AllAboutCircuits/C-BISCUIT/README.md

# C-BISCUIT
C-BISCUIT is a modular DIY robotic vehicle design based on the Freescale i.MX6 Wandboard and the Robotic Operating System (ROS).
