AllAboutCircuits/C-BISCUIT/core/power/README.md

# Power

## TODO

* Select R, C if special (power, ESR, whatever)
* Mega-Fit footprints
* Mounting hole footprints
* Fuse
    * Select holder
    * Make footprint
* Inductor footprint
* IC footprints?
* PCB layout
