AllAboutCircuits/C-BISCUIT/doc/research/README.md

# Research

This is a list of academic white papers and research articles used in the development of C-BISCUIT.

## Computer Vision

### LSD-SLAM: Large-Scale Direct Monocular SLAM
* [White Paper (PDF)](./lsd-slam.pdf)
* [Website](http://vision.in.tum.de/research/vslam/lsdslam)
* [Github](https://github.com/tum-vision/lsd_slam)

### SVO: Fast Semi-Direct Monocular Visual Odometry
* [White Paper (PDF)](./svo.pdf)
* [Demo Video](https://www.youtube.com/watch?v=2YnIMfw6bJY)
* [Github](https://github.com/uzh-rpg/rpg_svo)

### Digital Video Stabilization and Rolling Shutter Correction using Gyroscopes
* [White Paper](./rolling-shutter-gyro.pdf)
* [Website](https://graphics.stanford.edu/papers/stabilization/)
* [Github](https://github.com/alexgo1/Video-Stabilization)
