AllAboutCircuits/C-BISCUIT/core/wandboard/datasheets/README.md

# Datasheets

This is an incomplete list of parts on the Wandboard. They are included because we interact with them directly in some way and having the datasheet on hand would help with that process. Complete parts lists are in the schematics in [user-docs](../user-docs/).

* **[AME8816](./ame8816.pdf)** - 1.5A CMOS LDO. Provides 3.3V through header J2
