AllAboutCircuits/C-BISCUIT/core/wandboard/user-docs/README.md

# Wandboard Documentation and Materials

Local cache of the docs and files on the [Wandboard Downloads](http://www.wandboard.org/downloads) page.

* [Wandboard Quick Start Guide ](./wb-quick-start-guide.pdf)
* [Wandboard QUAD REV B1 Userguide + Schematics ](./wbq-rev-b1-guide-schem.pdf)
* [Wandboard CPU MOdule REV C1 Schematics ](./wb-cpu-module-rev-c1-schem.pdf)
* [Wandboard Baseboard REV C1 Schematics ](./wb-baseboard-rev-c1-schem.pdf)
* [Wandboard Enclosure Assembling Guide](./wb-enclosure-guide.pdf)
* [Wandboard 2D files ](./wb-2d-files.zip)
* [Wandboard Quad + Heatsink 3D files ](./wbq-3d-files.zip)
* [Enclosure 3D files](./wb-enclosure-3d-files.zip)
