AllAboutCircuits/C-BISCUIT/doc/articles/assets/2016-05-10 19.06.01.jpg

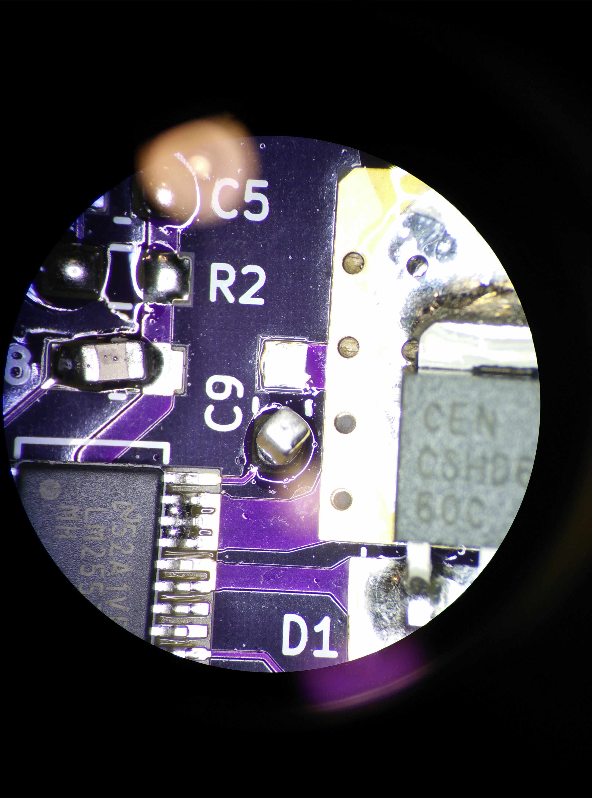
doc/articles/assets/2016-05-10 19.06.01.jpg
