AllAboutCircuits/C-BISCUIT/doc/articles/assets/2016-05-18 18.38.54.jpg

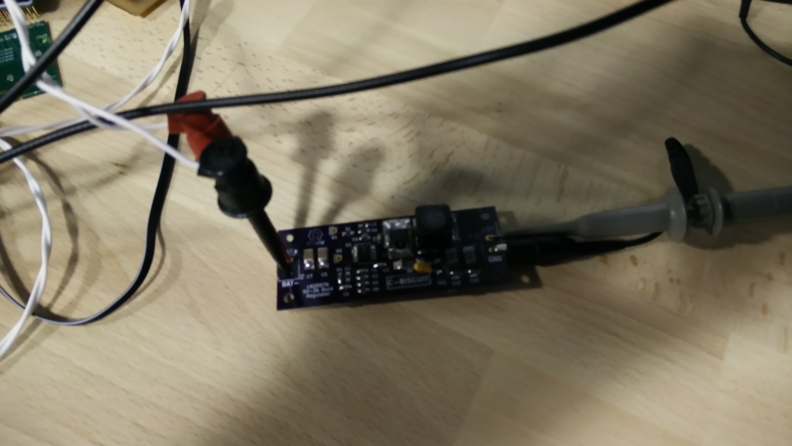
doc/articles/assets/2016-05-18 18.38.54.jpg
