AllAboutCircuits/C-BISCUIT/doc/articles/assets/crowbar_2016-03-14 15.54.27.jpg

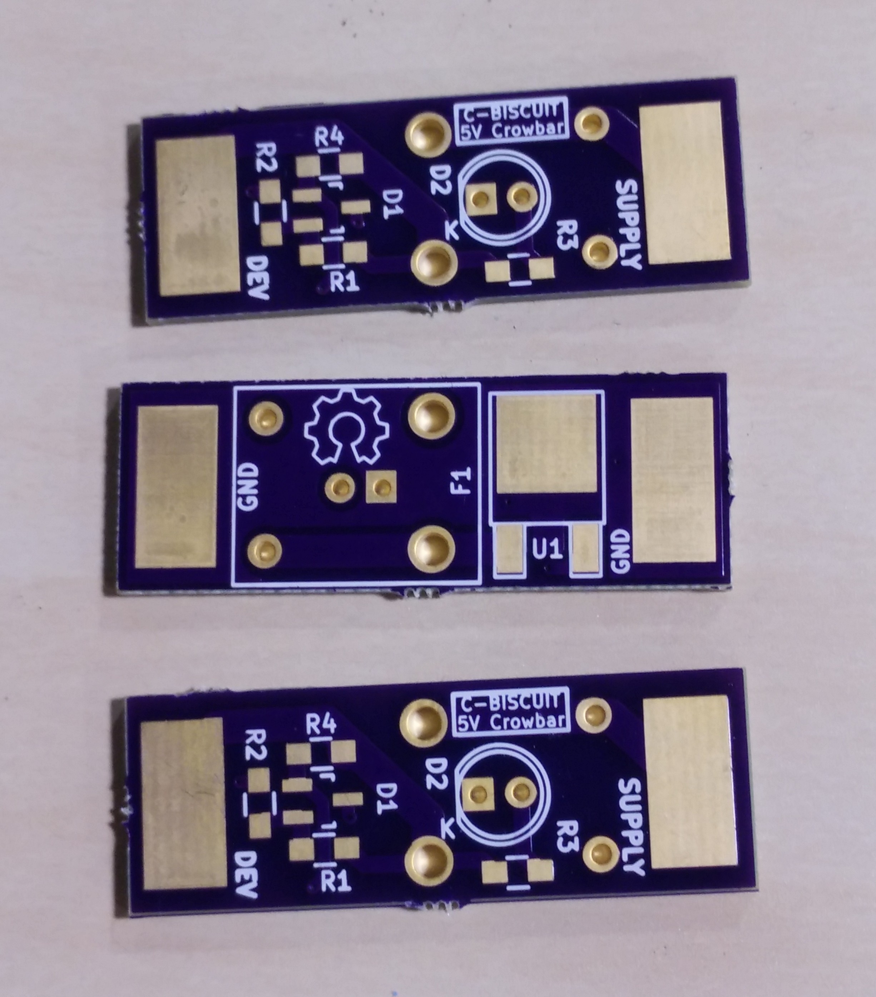
doc/articles/assets/crowbar_2016-03-14 15.54.27.jpg
