AllAboutCircuits/C-BISCUIT/doc/articles/assets/electricity-res.jpg

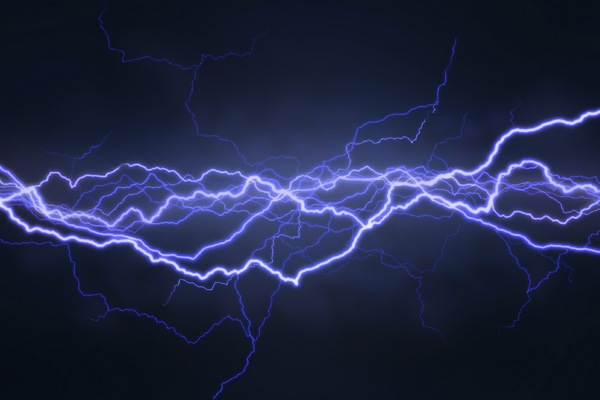
doc/articles/assets/electricity-res.jpg
