AllAboutCircuits/C-BISCUIT/doc/articles/assets/gordon-freeman-crowbar.jpg

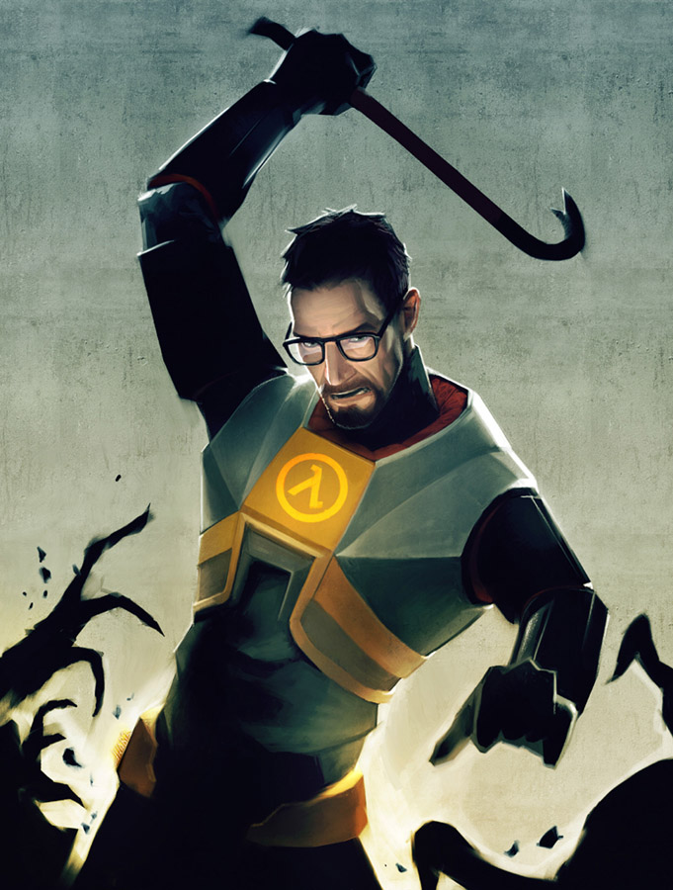
doc/articles/assets/gordon-freeman-crowbar.jpg
