AllAboutCircuits/C-BISCUIT/doc/articles/assets/reflow-profile.jpg

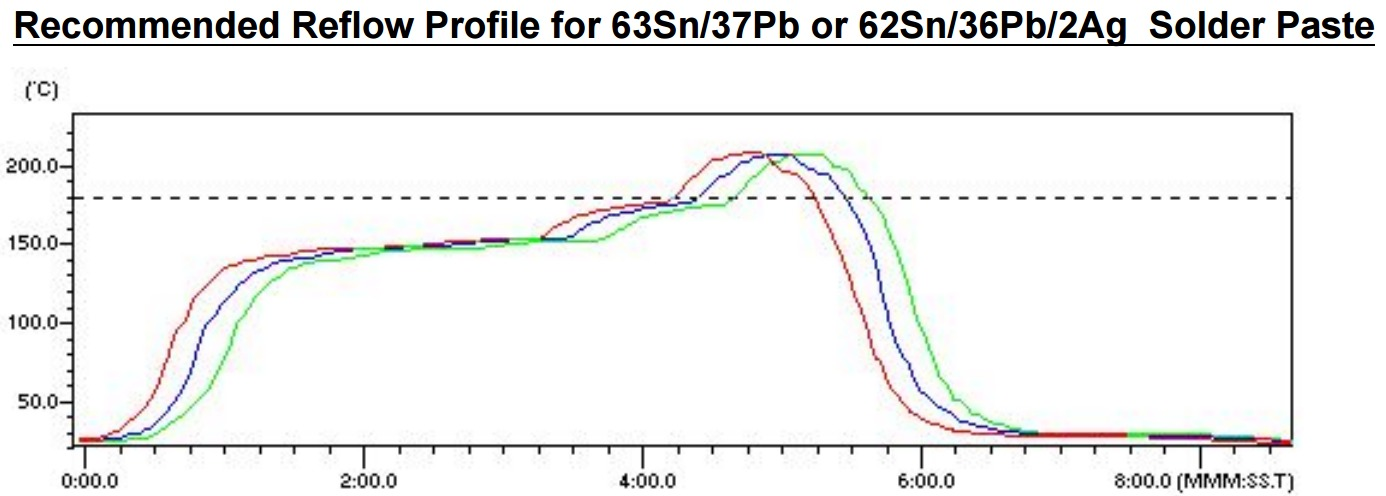
doc/articles/assets/reflow-profile.jpg
