AllAboutCircuits/C-BISCUIT/doc/articles/assets/reg_2016-05-10 17.44.28.jpg

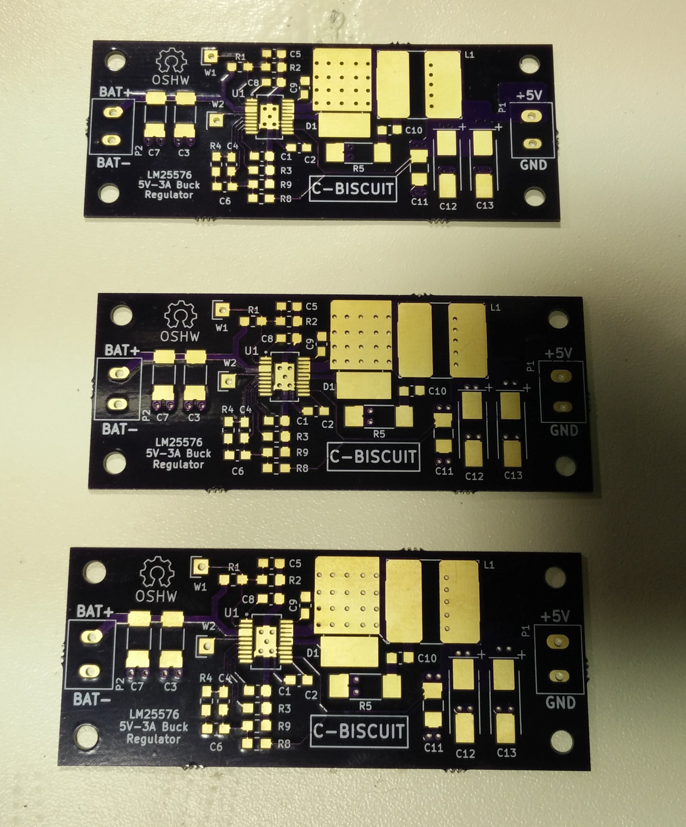
doc/articles/assets/reg_2016-05-10 17.44.28.jpg
