AllAboutCircuits/C-BISCUIT/doc/articles/assets/triac_quad_iii.jpg

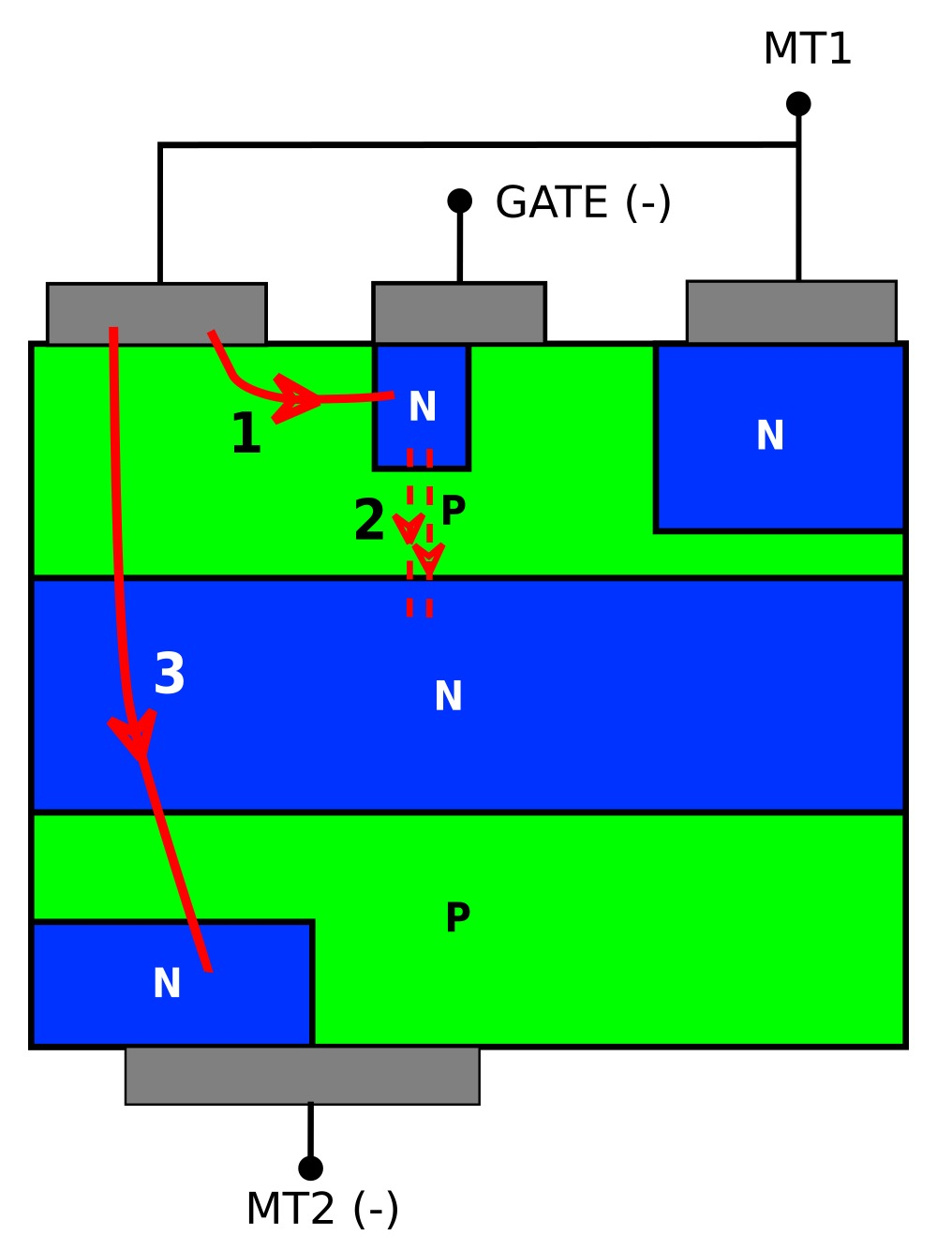
doc/articles/assets/triac_quad_iii.jpg
