AllAboutCircuits/C-BISCUIT/core/wandboard/user-docs/wb-enclosure-guide.pdf

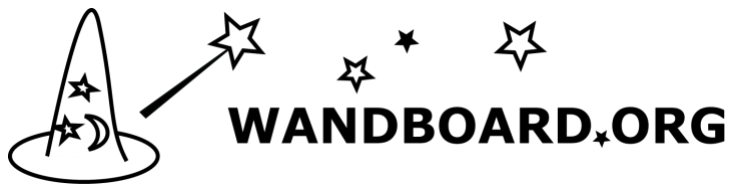
[picture p42: figure]

# Assembly Guide Enclosure

If you do not need to attach an antenna, just follow steps 1,4 and 6.

Step 1 - Place the top-case on a soft surface

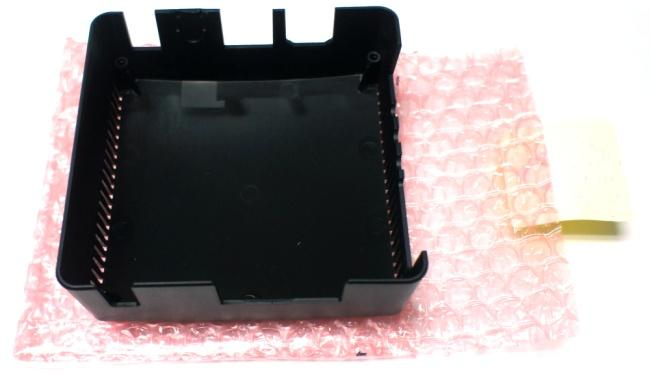
[picture p43: figure]

Step 2 (optional)- If you have a Wandboard with Wi-Fi capabilities (Wandboard DUAL). You will need to open the antenna opening

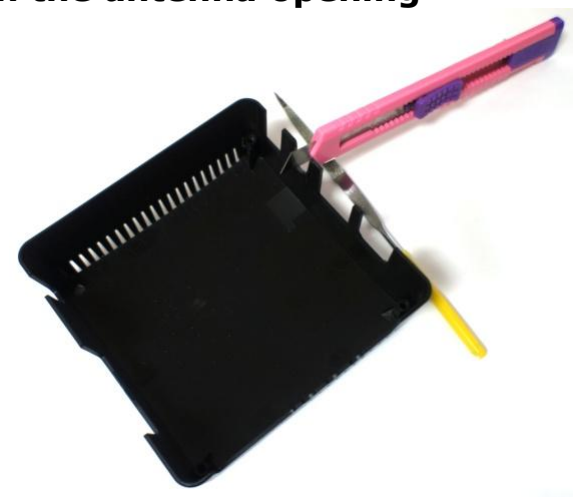
[picture p44: figure]
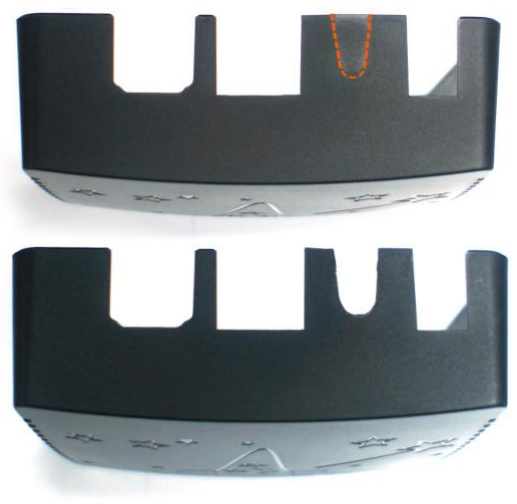
[picture p45: figure]

Step 3 (optional)- Connect the Wi-Fi cable: plug the cable in the μFL IPEX connector and lead it through the open hole to the other side

After

Before

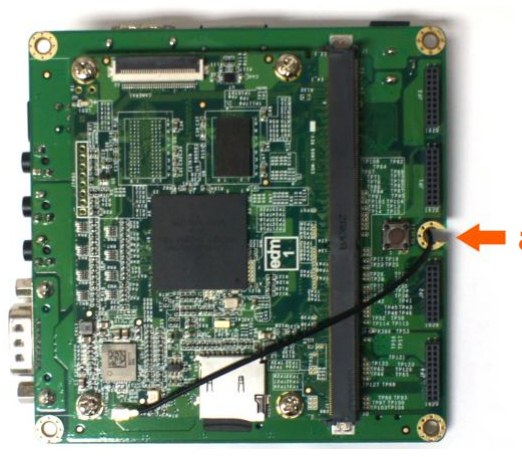
[picture p46: figure]

hole for
antenna
cable

Step 4 - Insert your Wandboard (remember to insert SD-card with OS in the module first)

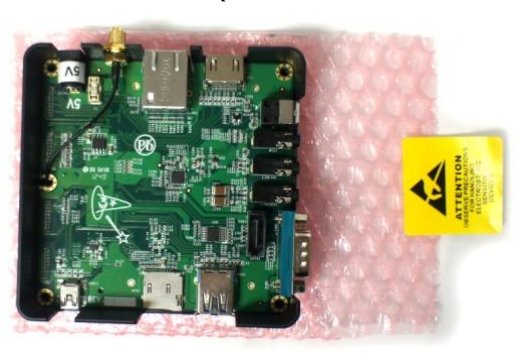
[picture p47: figure]

Step 5 (optional) - Make sure the bolt has the correct orientation, and then fasten it (the rings should be on the outside of the case)

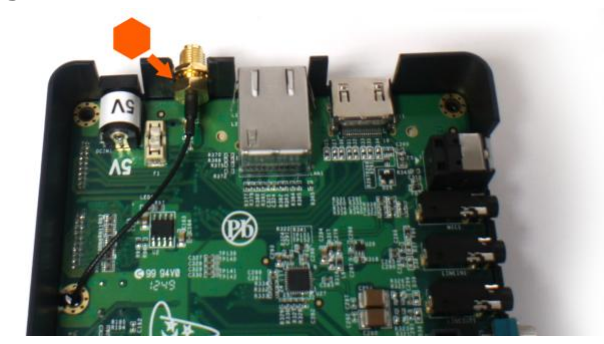
[picture p48: figure]

Step 6 - Insert and fasten the bottom-enclosure with the screws and attach the rubber feet.

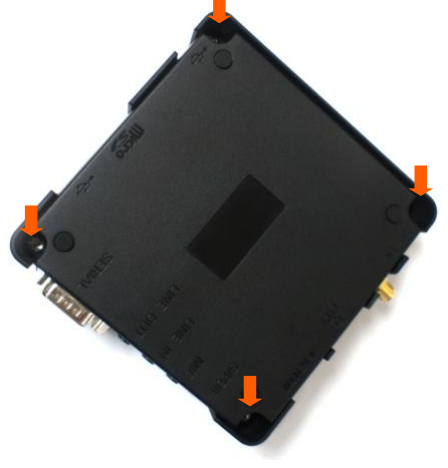
[picture p49: figure]
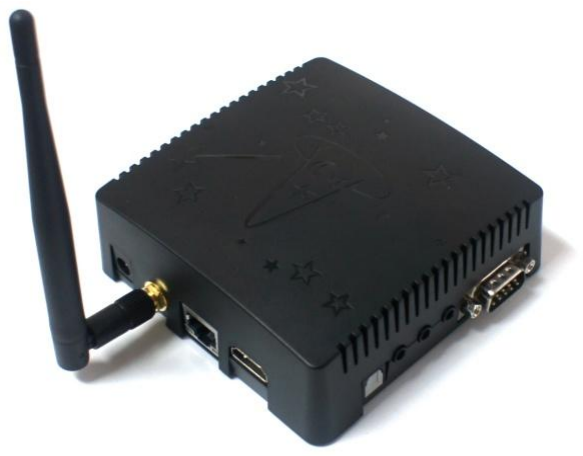
[picture p50: figure]

Step 7 (optional) - Attach the antenna.
