AllAboutCircuits/C-BISCUIT/core/wandboard/user-docs/wb-baseboard-rev-c1-schem.pdf

# PCB SN:100300490411 L=4, 95 x 95 mm

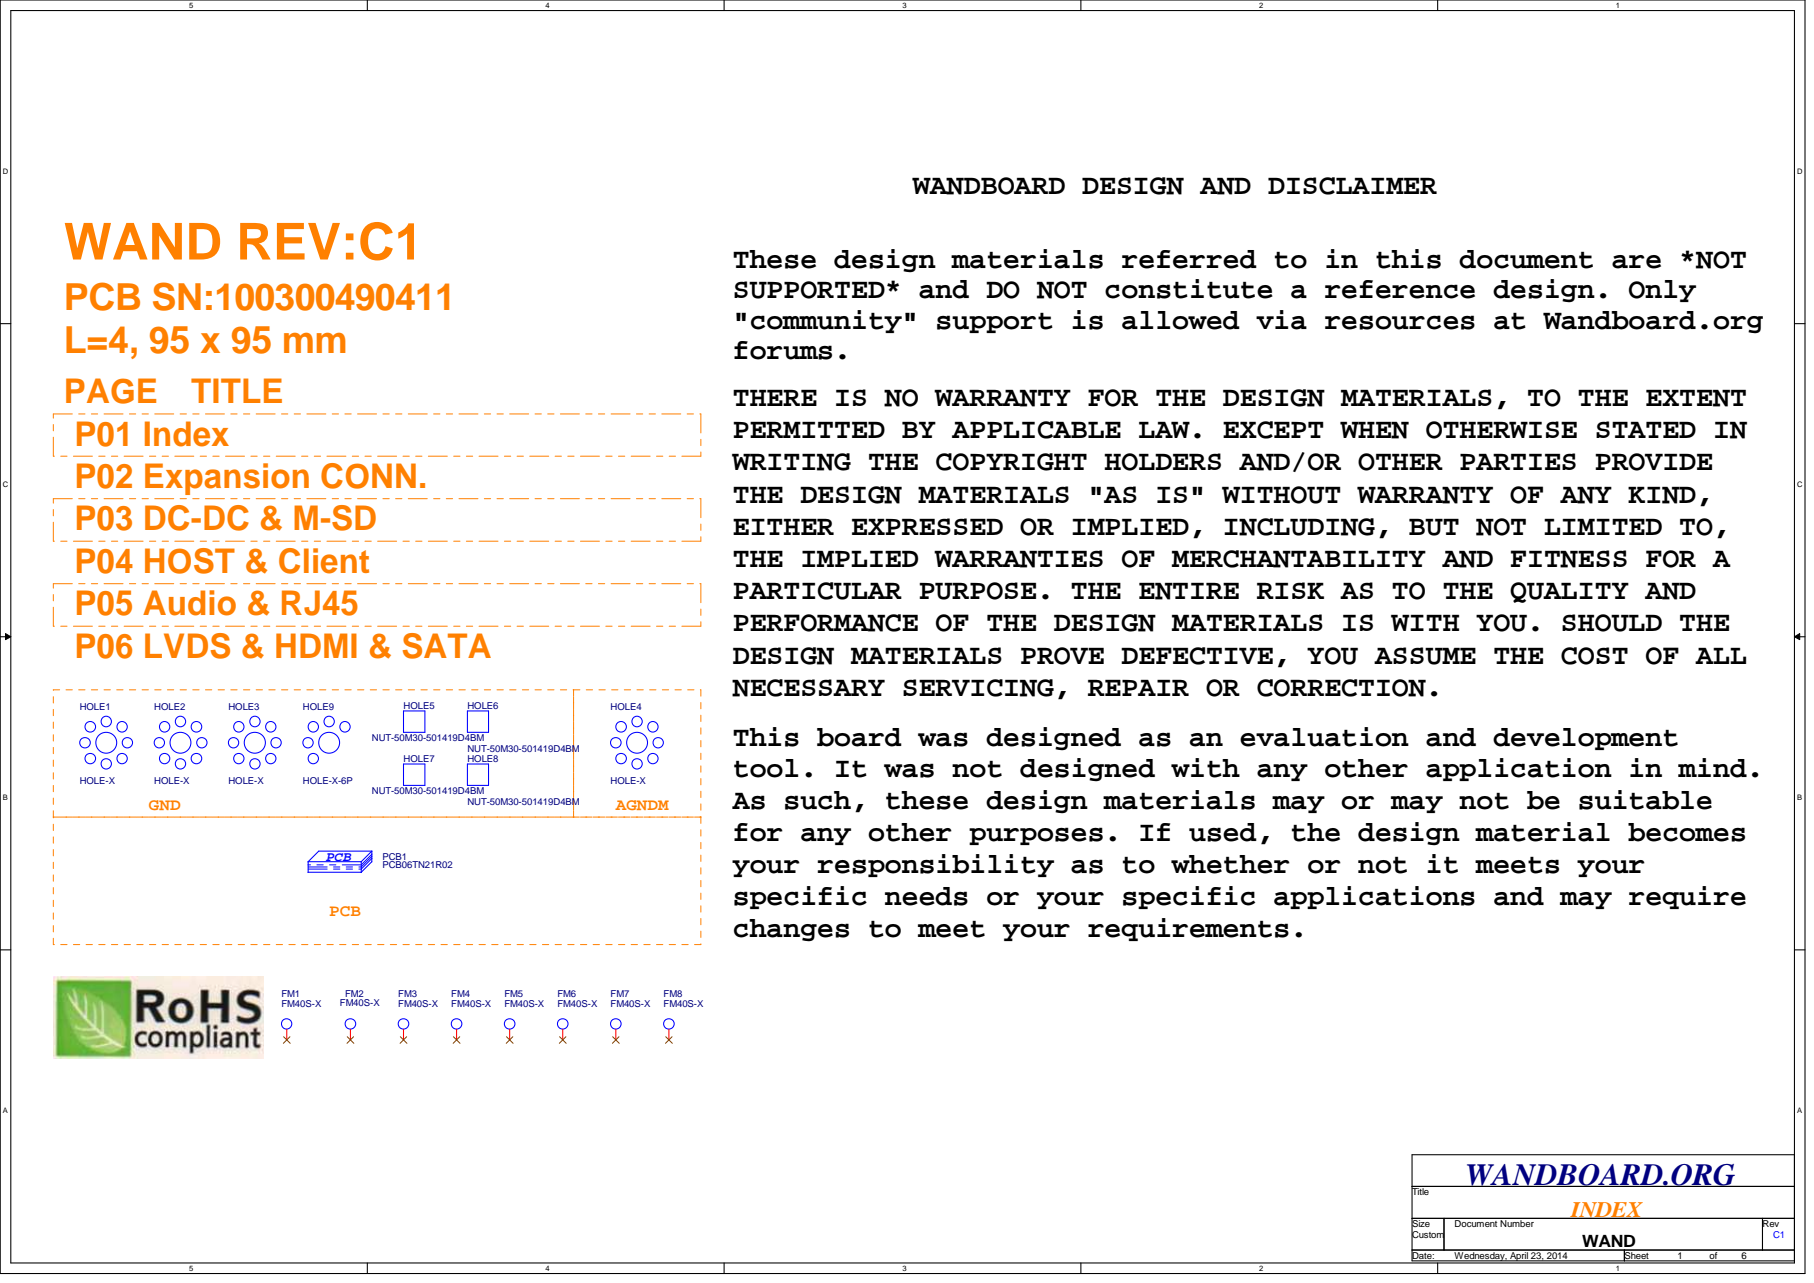
[picture p83: page 1]
WAND REV:C1; GND; AGNDM; PCB; INDEX; WANDBOARD.ORG; Title; HOLE9; HOLE-X-6P; HOLE4; HOLE-X; HOLE3; HOLE6; NUT-50M30-501419D4BM; HOLE2; HOLE5; HOLE7; HOLE8; PCB06TN21R02; PCB1; HOLE1

WANDBOARD DESIGN AND DISCLAIMER

These design materials referred to in this document are *NOT
SUPPORTED* and DO NOT constitute a reference design. Only
"community" support is allowed via resources at Wandboard.org
forums.
THERE IS NO WARRANTY FOR THE DESIGN MATERIALS, TO THE EXTENT
PERMITTED BY APPLICABLE LAW. EXCEPT WHEN OTHERWISE STATED IN
WRITING THE COPYRIGHT HOLDERS AND/OR OTHER PARTIES PROVIDE
THE DESIGN MATERIALS "AS IS" WITHOUT WARRANTY OF ANY KIND,
EITHER EXPRESSED OR IMPLIED, INCLUDING, BUT NOT LIMITED TO,
THE IMPLIED WARRANTIES OF MERCHANTABILITY AND FITNESS FOR A
PARTICULAR PURPOSE. THE ENTIRE RISK AS TO THE QUALITY AND
PERFORMANCE OF THE DESIGN MATERIALS IS WITH YOU. SHOULD THE
DESIGN MATERIALS PROVE DEFECTIVE, YOU ASSUME THE COST OF ALL
NECESSARY SERVICING, REPAIR OR CORRECTION.
This board was designed as an evaluation and development
tool. It was not designed with any other application in mind.
As such, these design materials may or may not be suitable
for any other purposes. If used, the design material becomes
your responsibility as to whether or not it meets your
specific needs or your specific applications and may require
changes to meet your requirements.

PAGE TITLE
P01 Index
P02 Expansion CONN.
P04 HOST & Client
P05 Audio & RJ45
P06 LVDS & HDMI & SATA

Size Custom | Document Number WAND | Rev C1

Date: Wednesday, April 23, 2014 | Sheet 1 of 6

# Board to Board

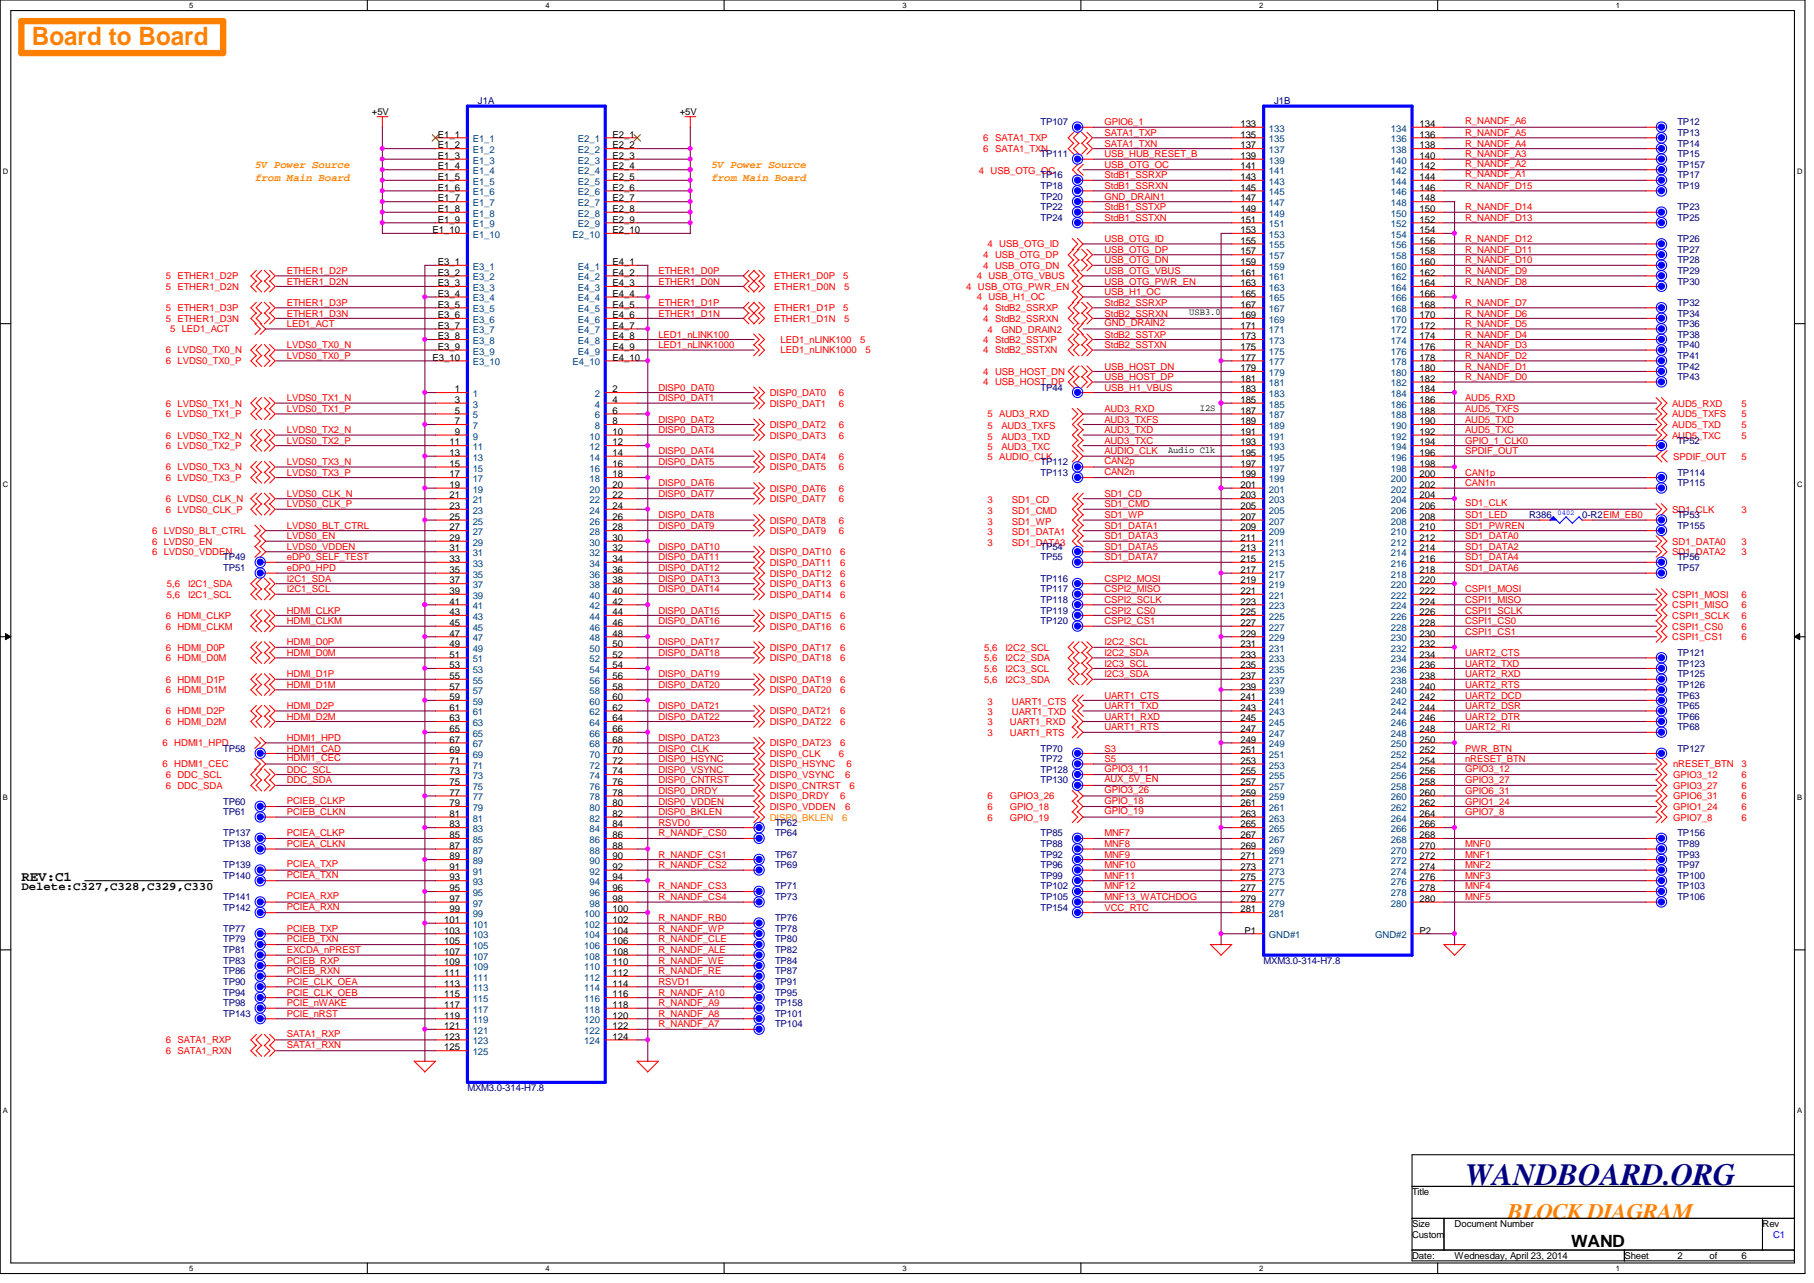
[picture p84: page 2]

# DC-DC

# DC JACK

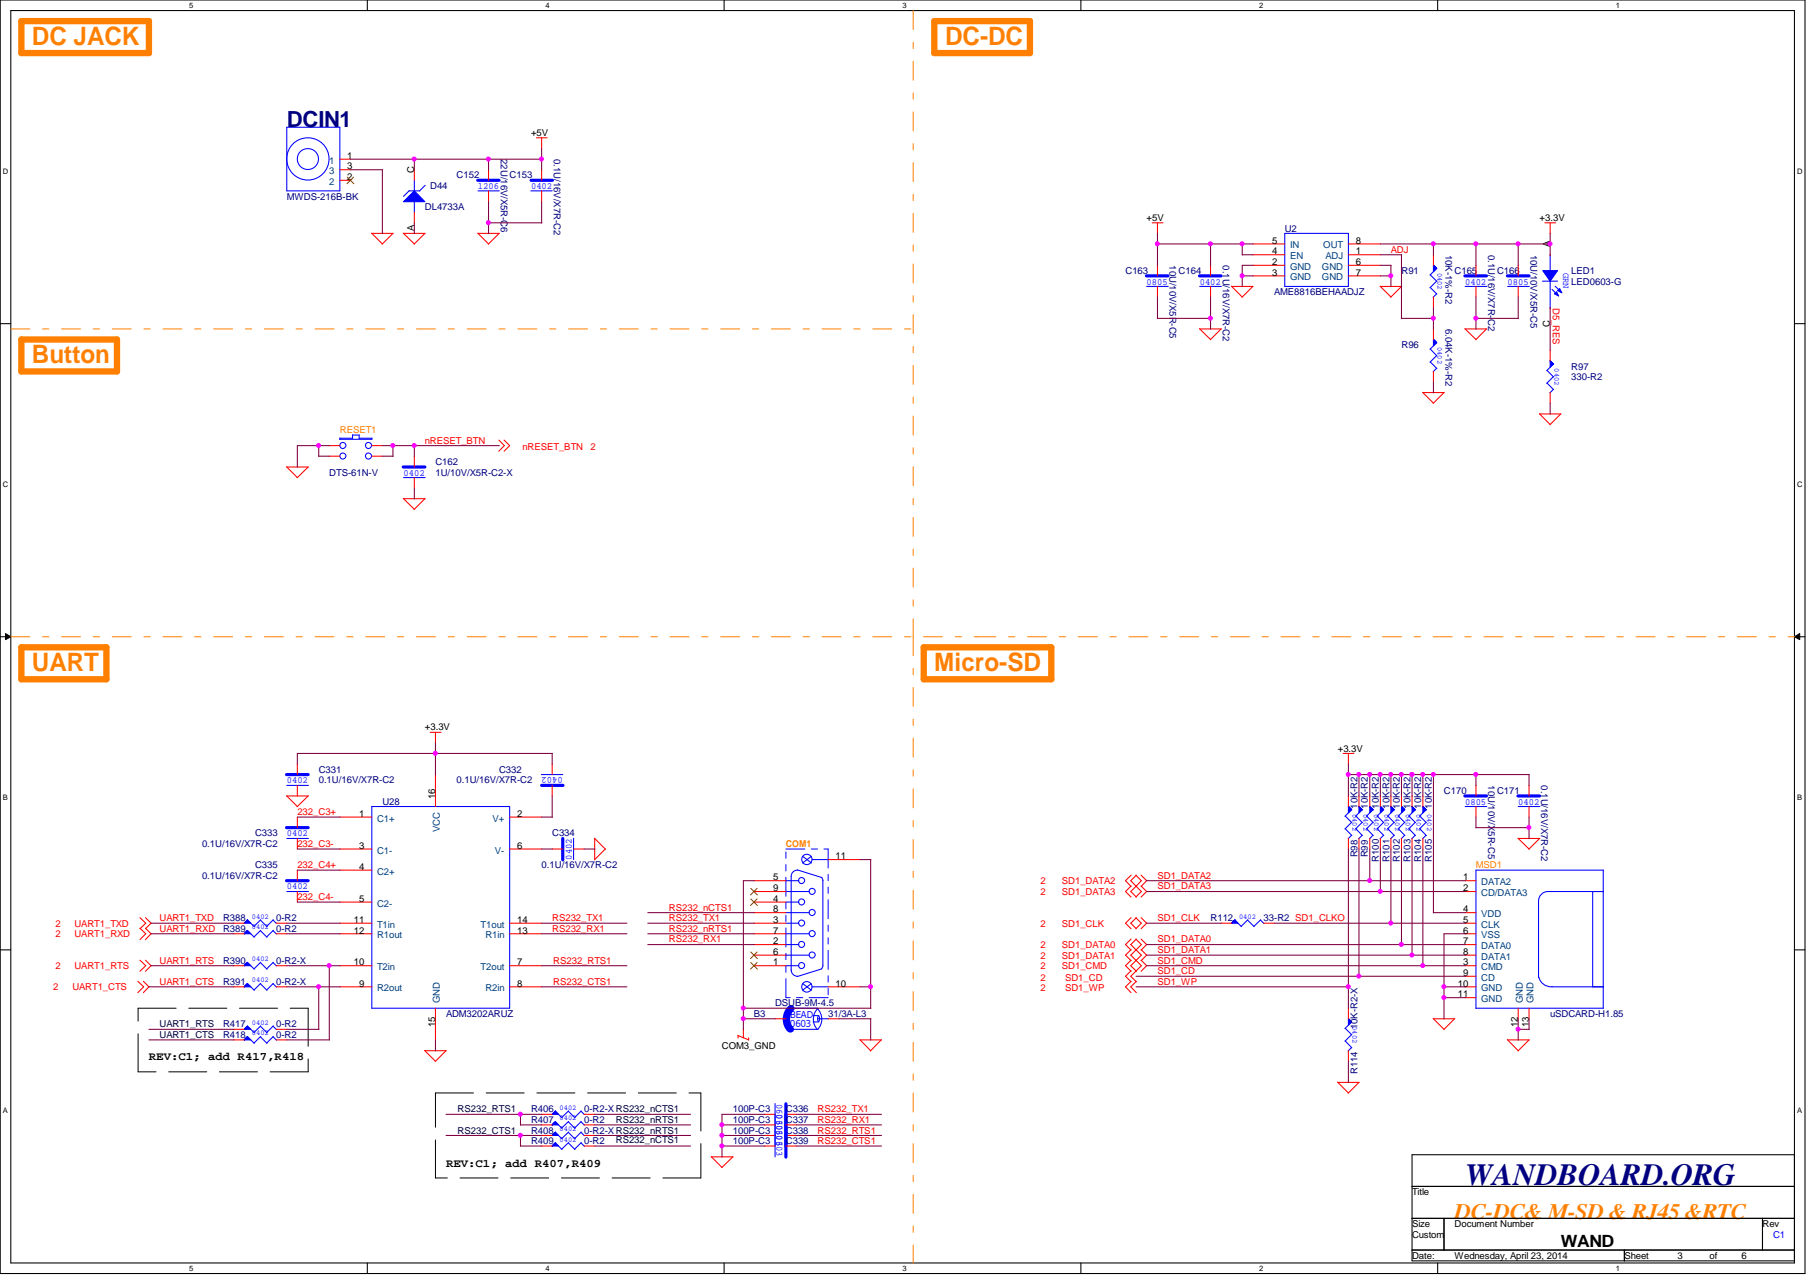
[picture p85: page 3]

WANDBOARD.ORG
DC-DC& M-SD & RJ45 &RTC

# HOST USB

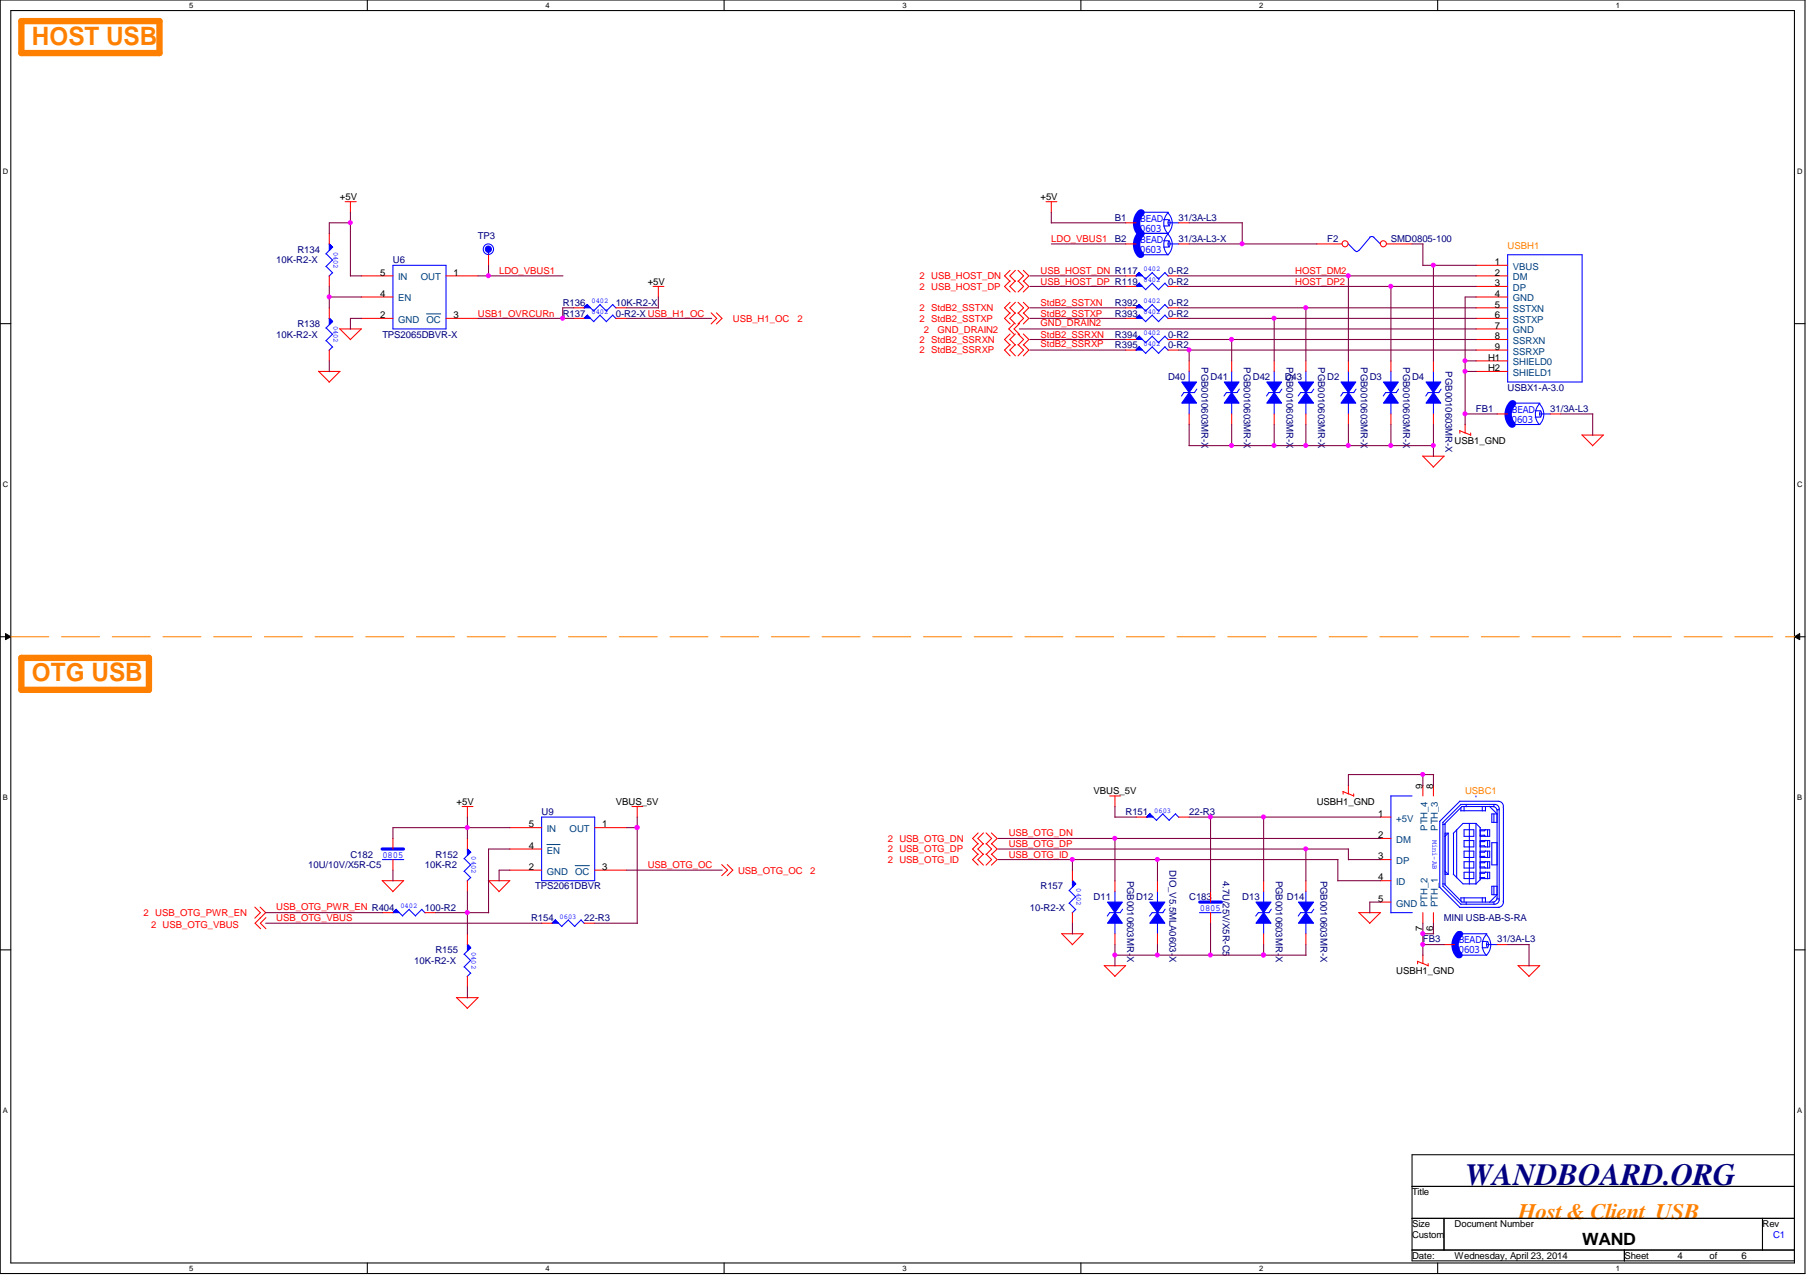
[picture p86: page 4]

MINI USB-AB-S-RA

# AUDIO

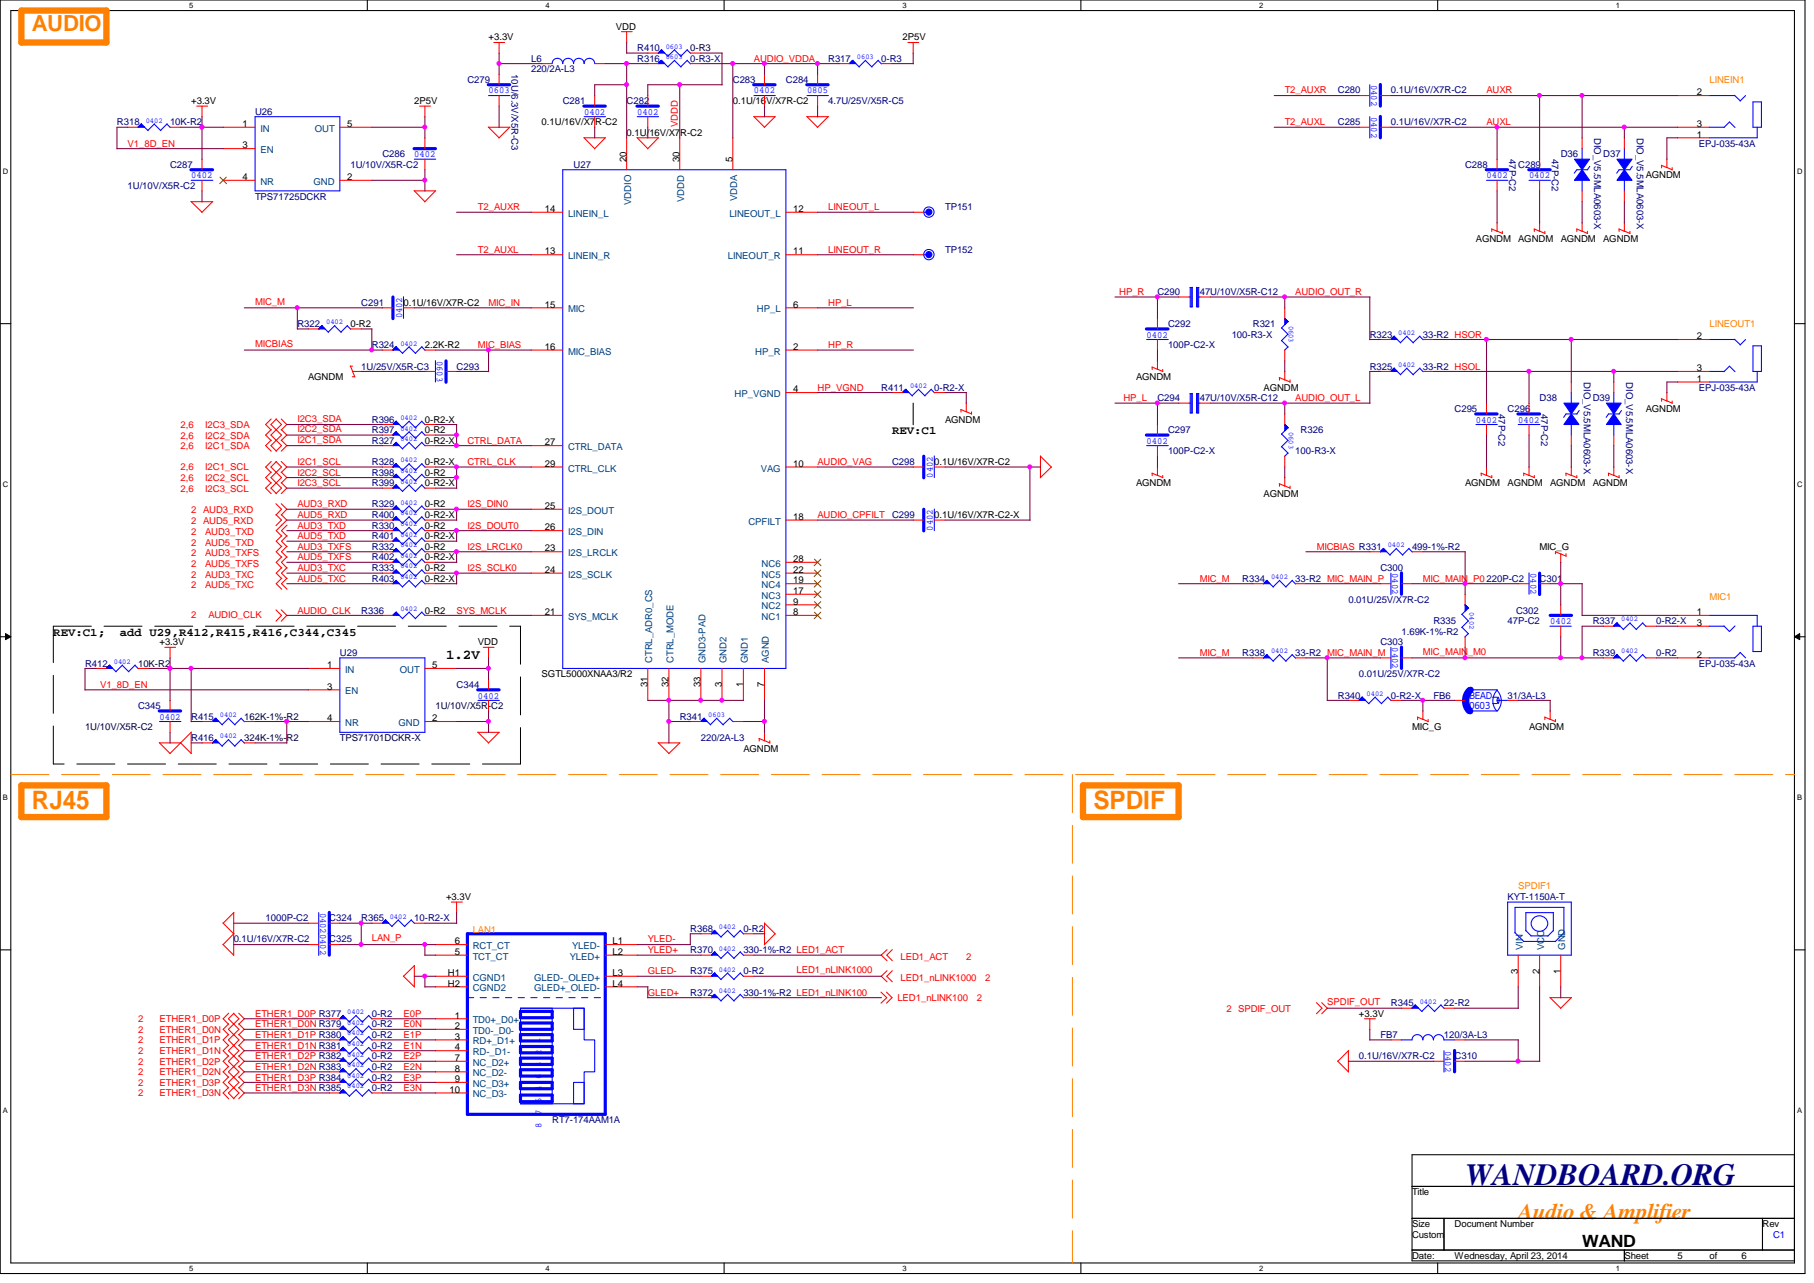
[picture p87: page 5]

AGNDM AGNDM

# TTL

# LVDS

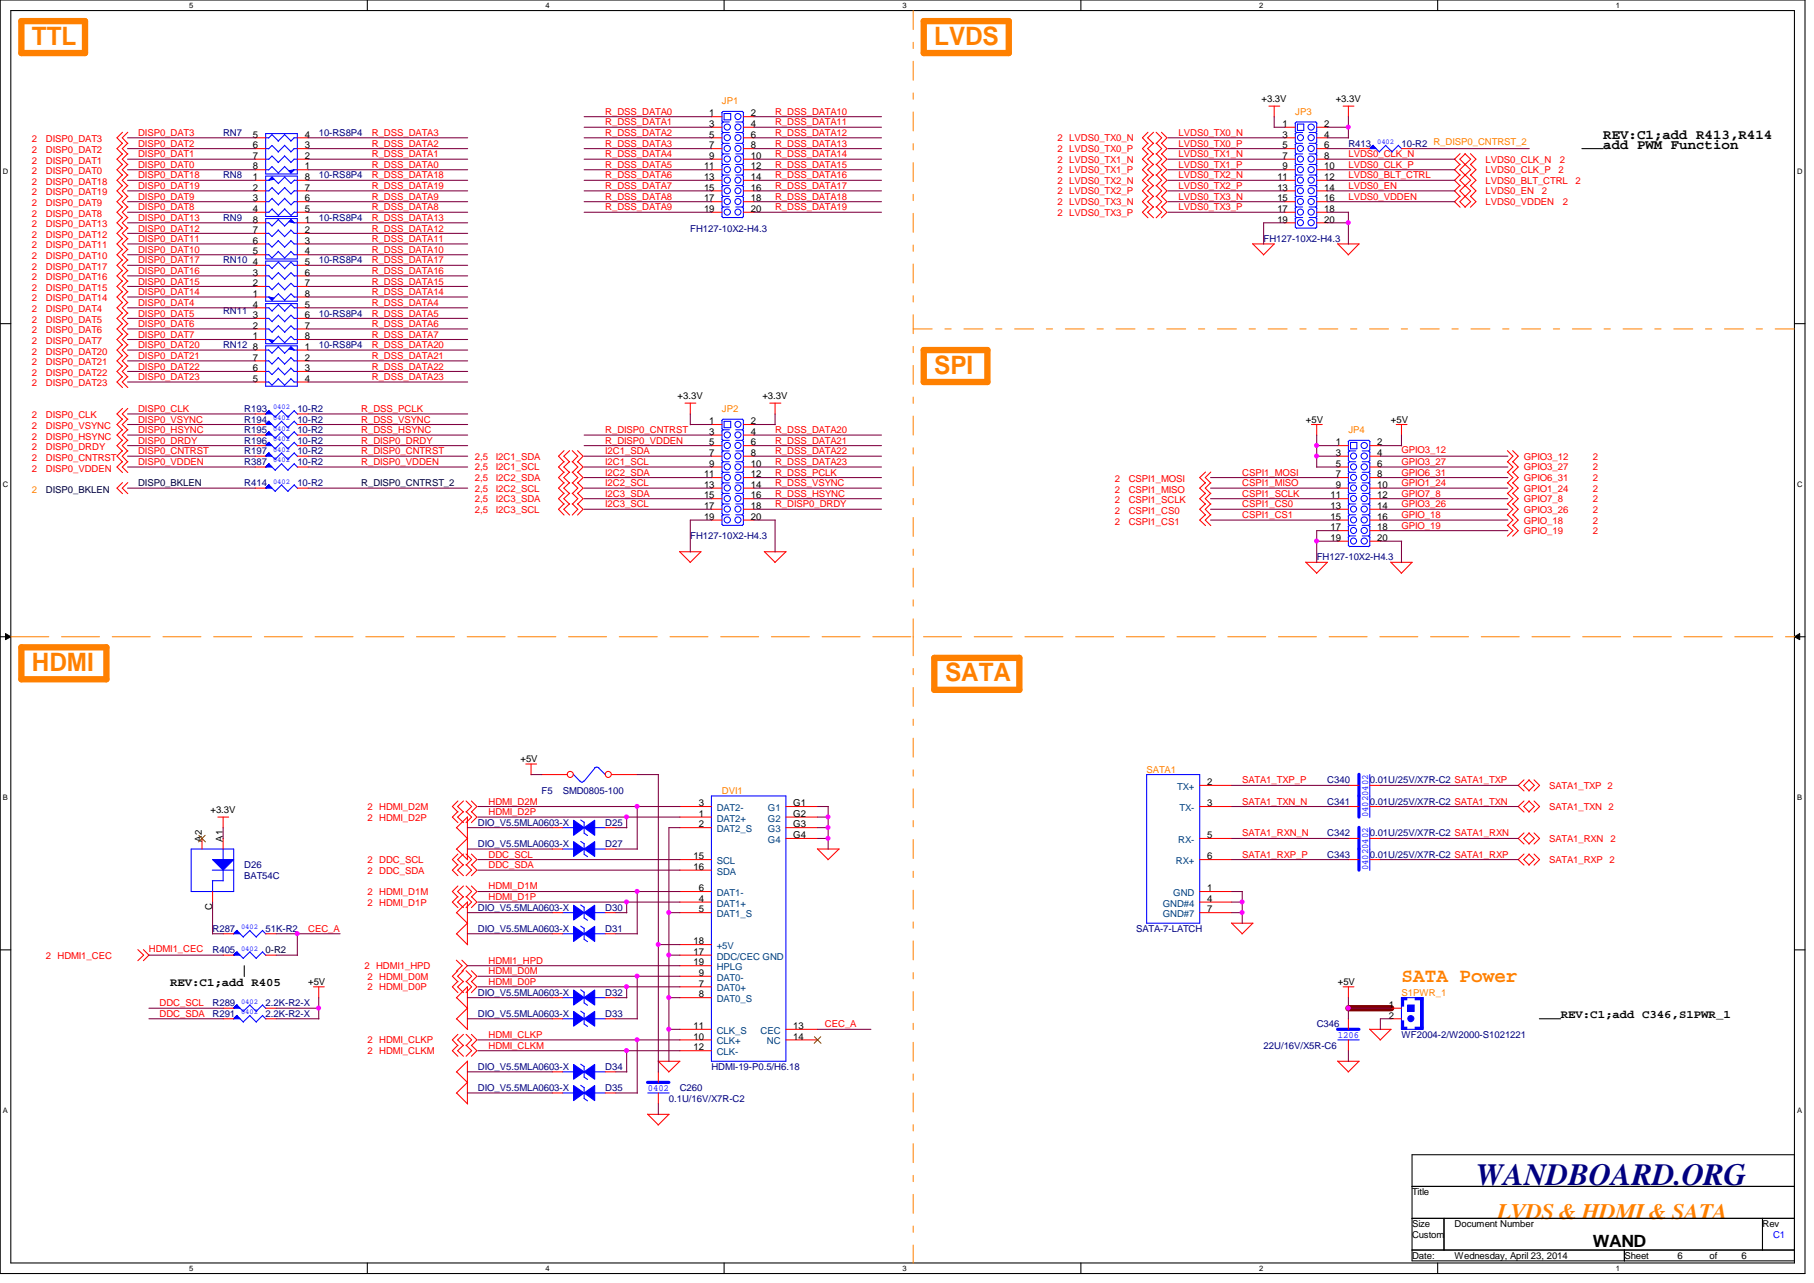
[picture p88: page 6]
