AllAboutCircuits/C-BISCUIT/core/wandboard/user-docs/wb-cpu-module-rev-c1-schem.pdf

# L=8, 82 x 60mm

# PCB SN:101200480811

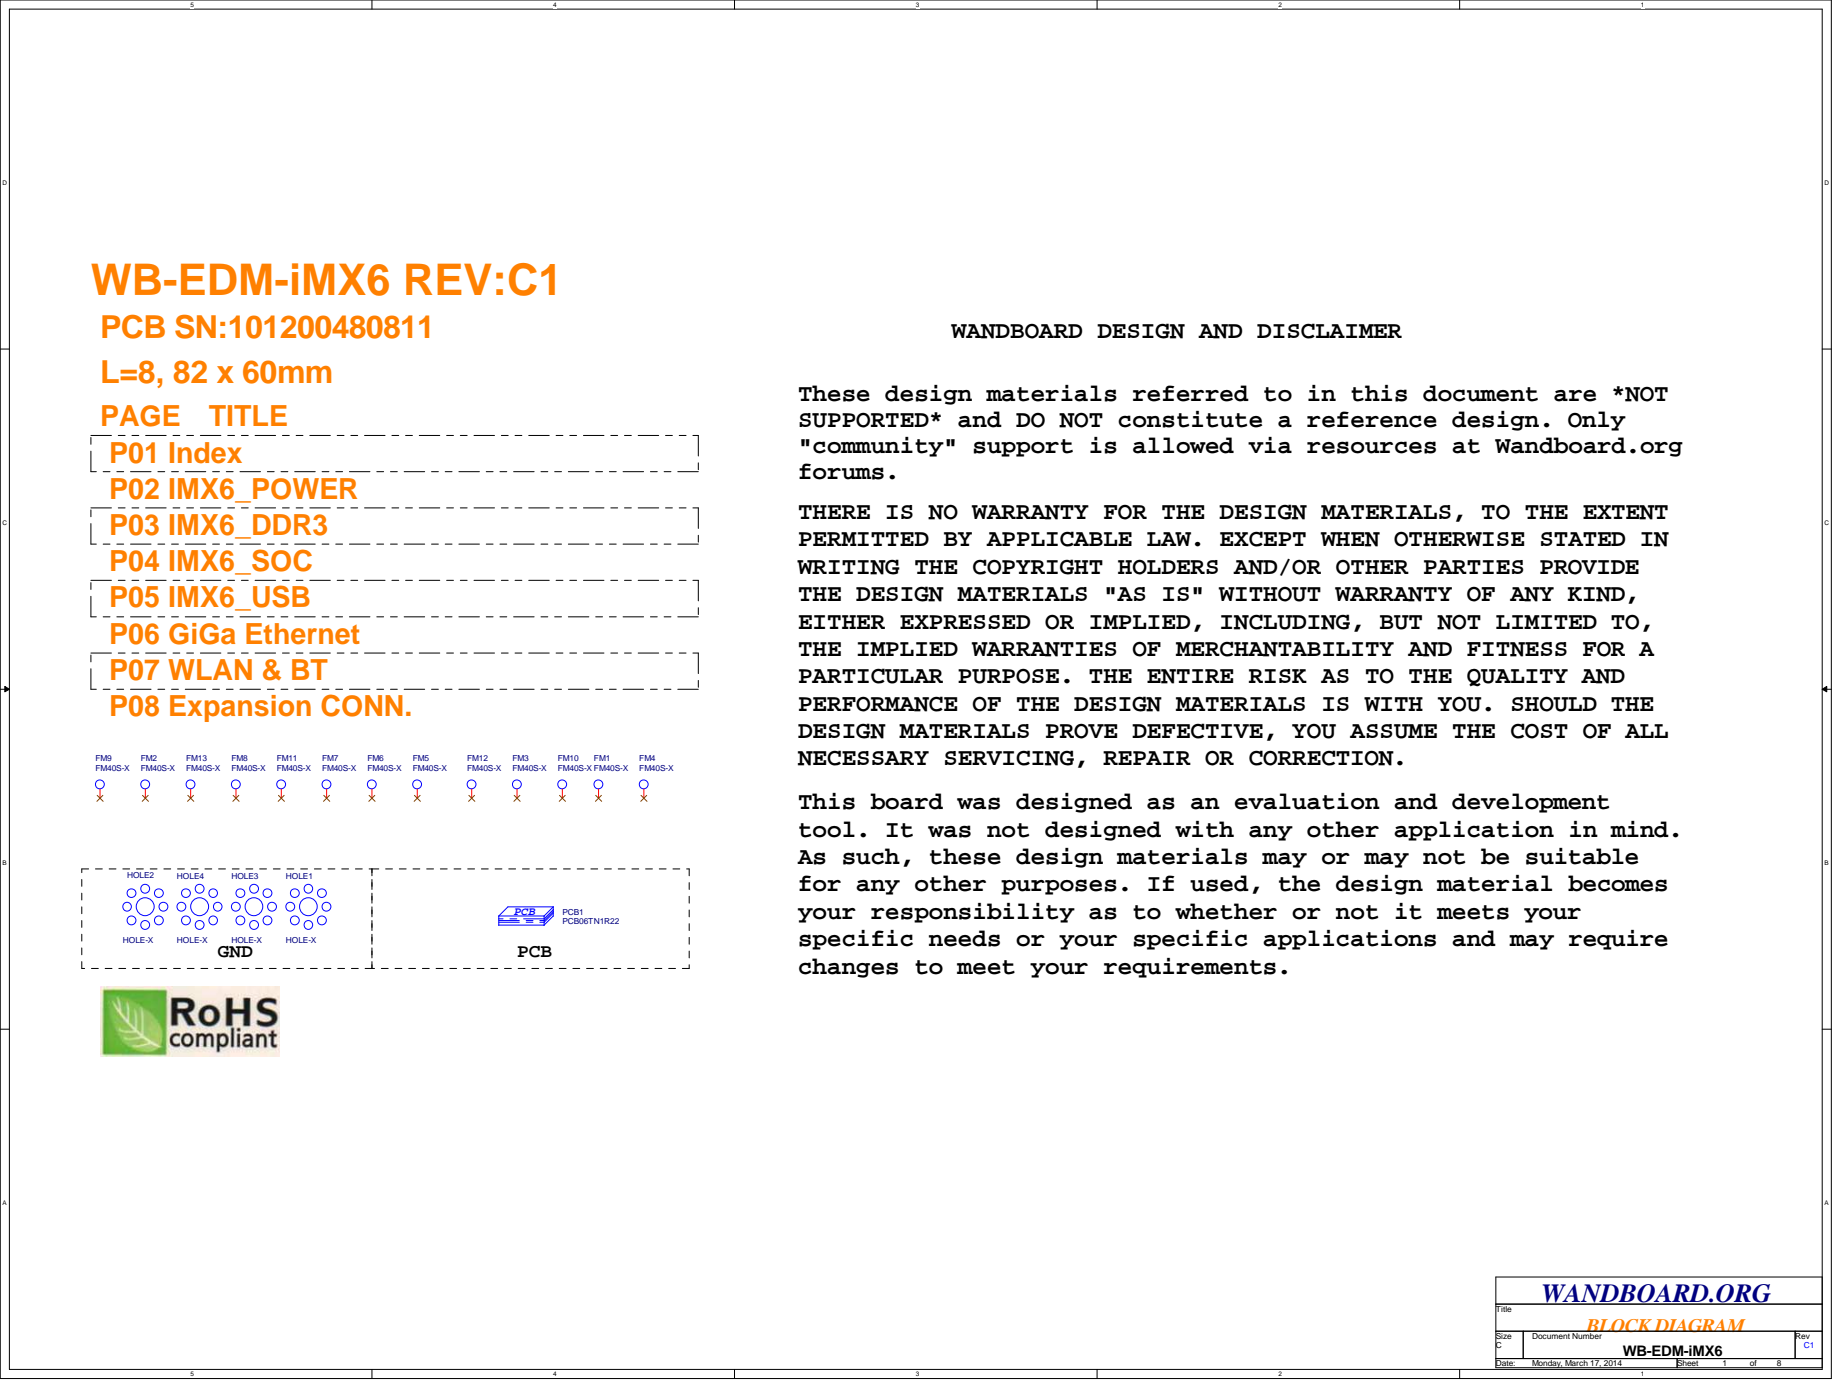
[picture p89: page 1]

WANDBOARD DESIGN AND DISCLAIMER

These design materials referred to in this document are *NOT
SUPPORTED* and DO NOT constitute a reference design. Only
"community" support is allowed via resources at Wandboard.org
forums.
THERE IS NO WARRANTY FOR THE DESIGN MATERIALS, TO THE EXTENT
PERMITTED BY APPLICABLE LAW. EXCEPT WHEN OTHERWISE STATED IN
WRITING THE COPYRIGHT HOLDERS AND/OR OTHER PARTIES PROVIDE
THE DESIGN MATERIALS "AS IS" WITHOUT WARRANTY OF ANY KIND,
EITHER EXPRESSED OR IMPLIED, INCLUDING, BUT NOT LIMITED TO,
THE IMPLIED WARRANTIES OF MERCHANTABILITY AND FITNESS FOR A
PARTICULAR PURPOSE. THE ENTIRE RISK AS TO THE QUALITY AND
PERFORMANCE OF THE DESIGN MATERIALS IS WITH YOU. SHOULD THE
DESIGN MATERIALS PROVE DEFECTIVE, YOU ASSUME THE COST OF ALL
NECESSARY SERVICING, REPAIR OR CORRECTION.
This board was designed as an evaluation and development
tool. It was not designed with any other application in mind.
As such, these design materials may or may not be suitable
for any other purposes. If used, the design material becomes
your responsibility as to whether or not it meets your
specific needs or your specific applications and may require
changes to meet your requirements.

## i.MX6Q - POWER

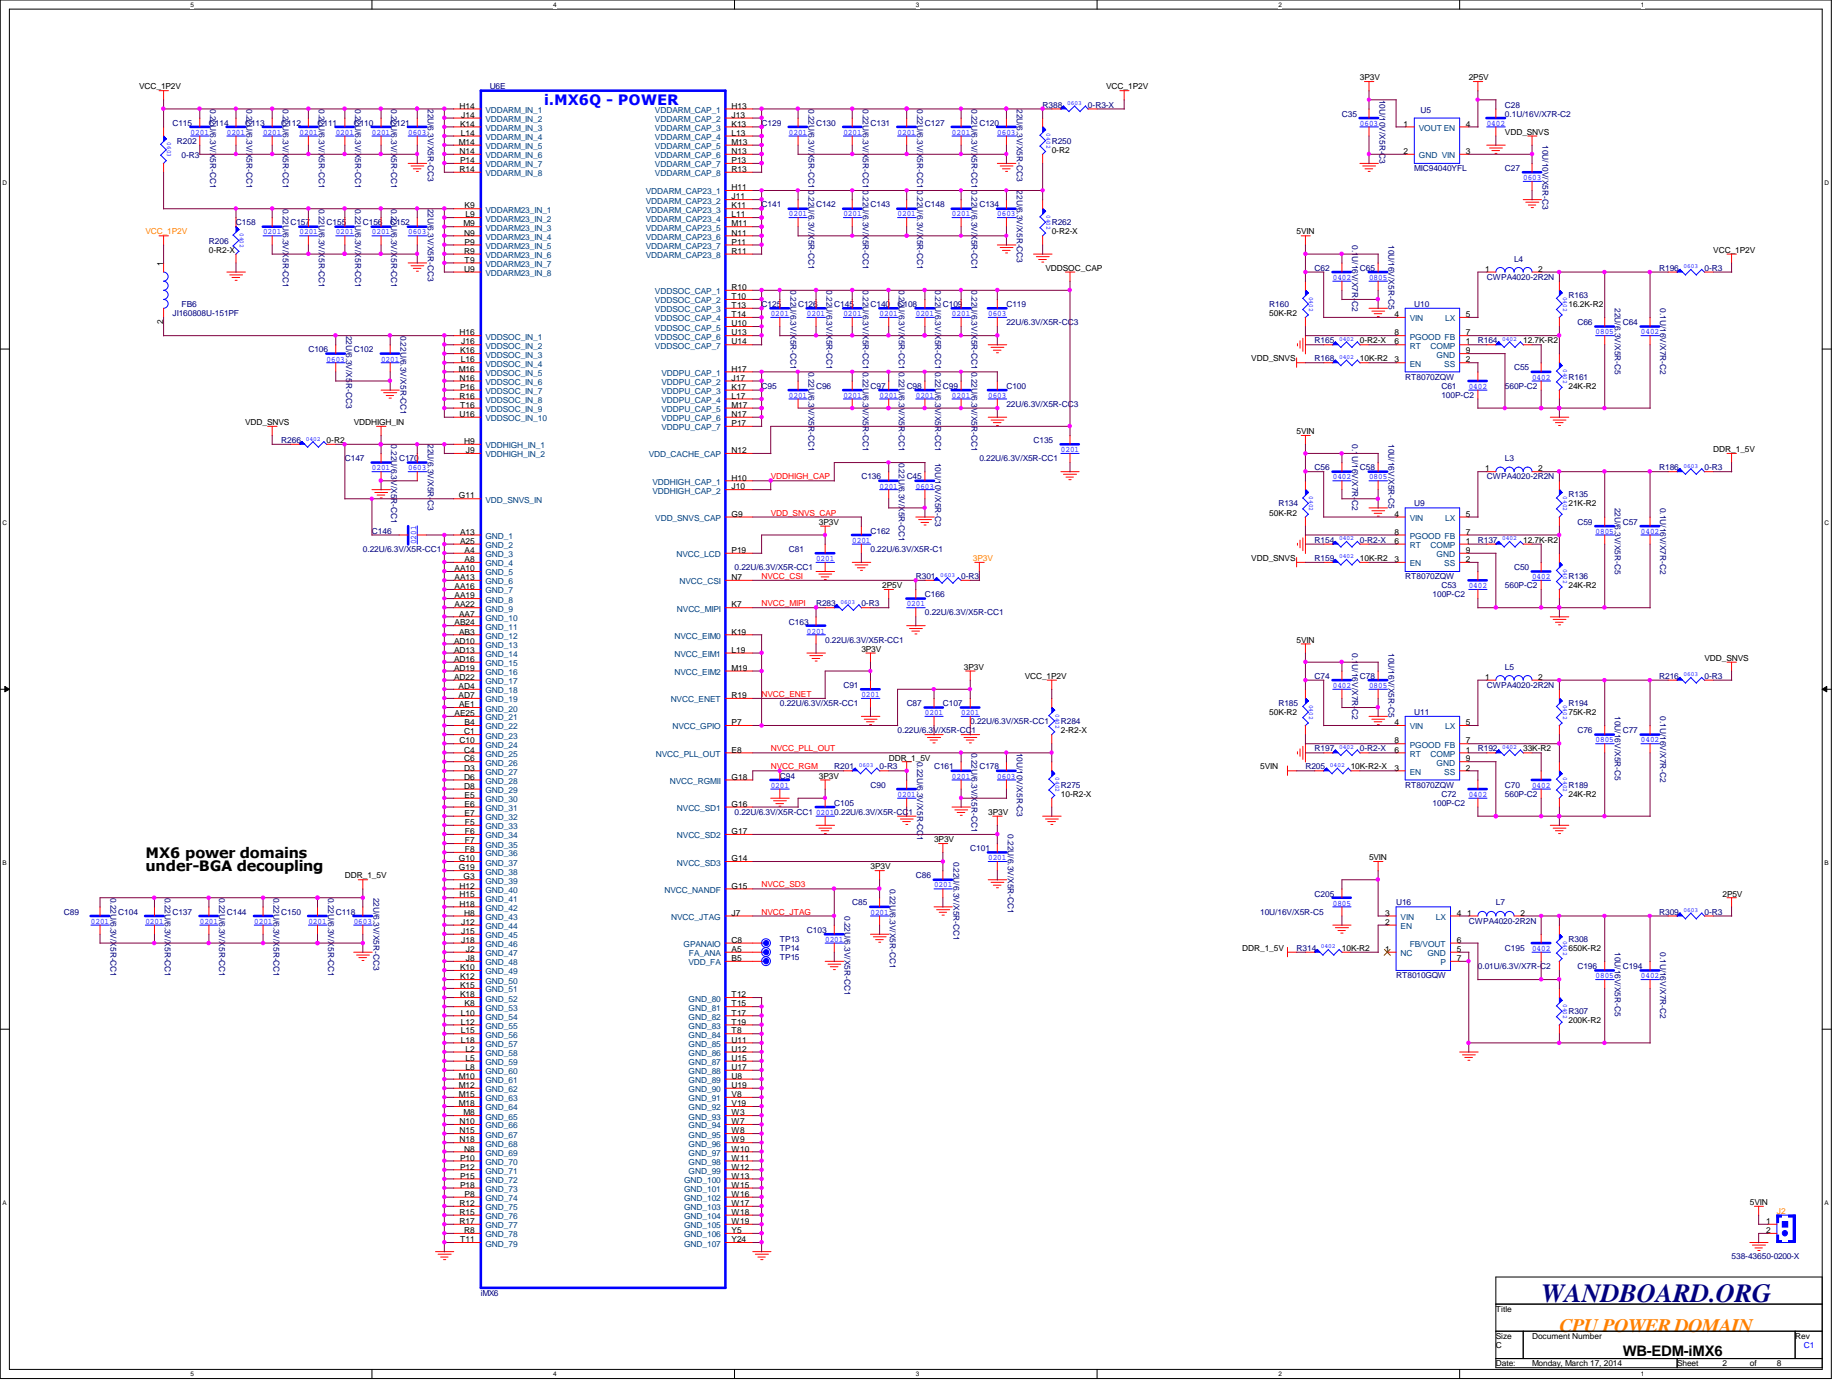
[picture p90: page 2]

MX6 power domains under-BGA decoupling

## DDR3 2GB

## 2G_DDR3_SDRAM_128MX16

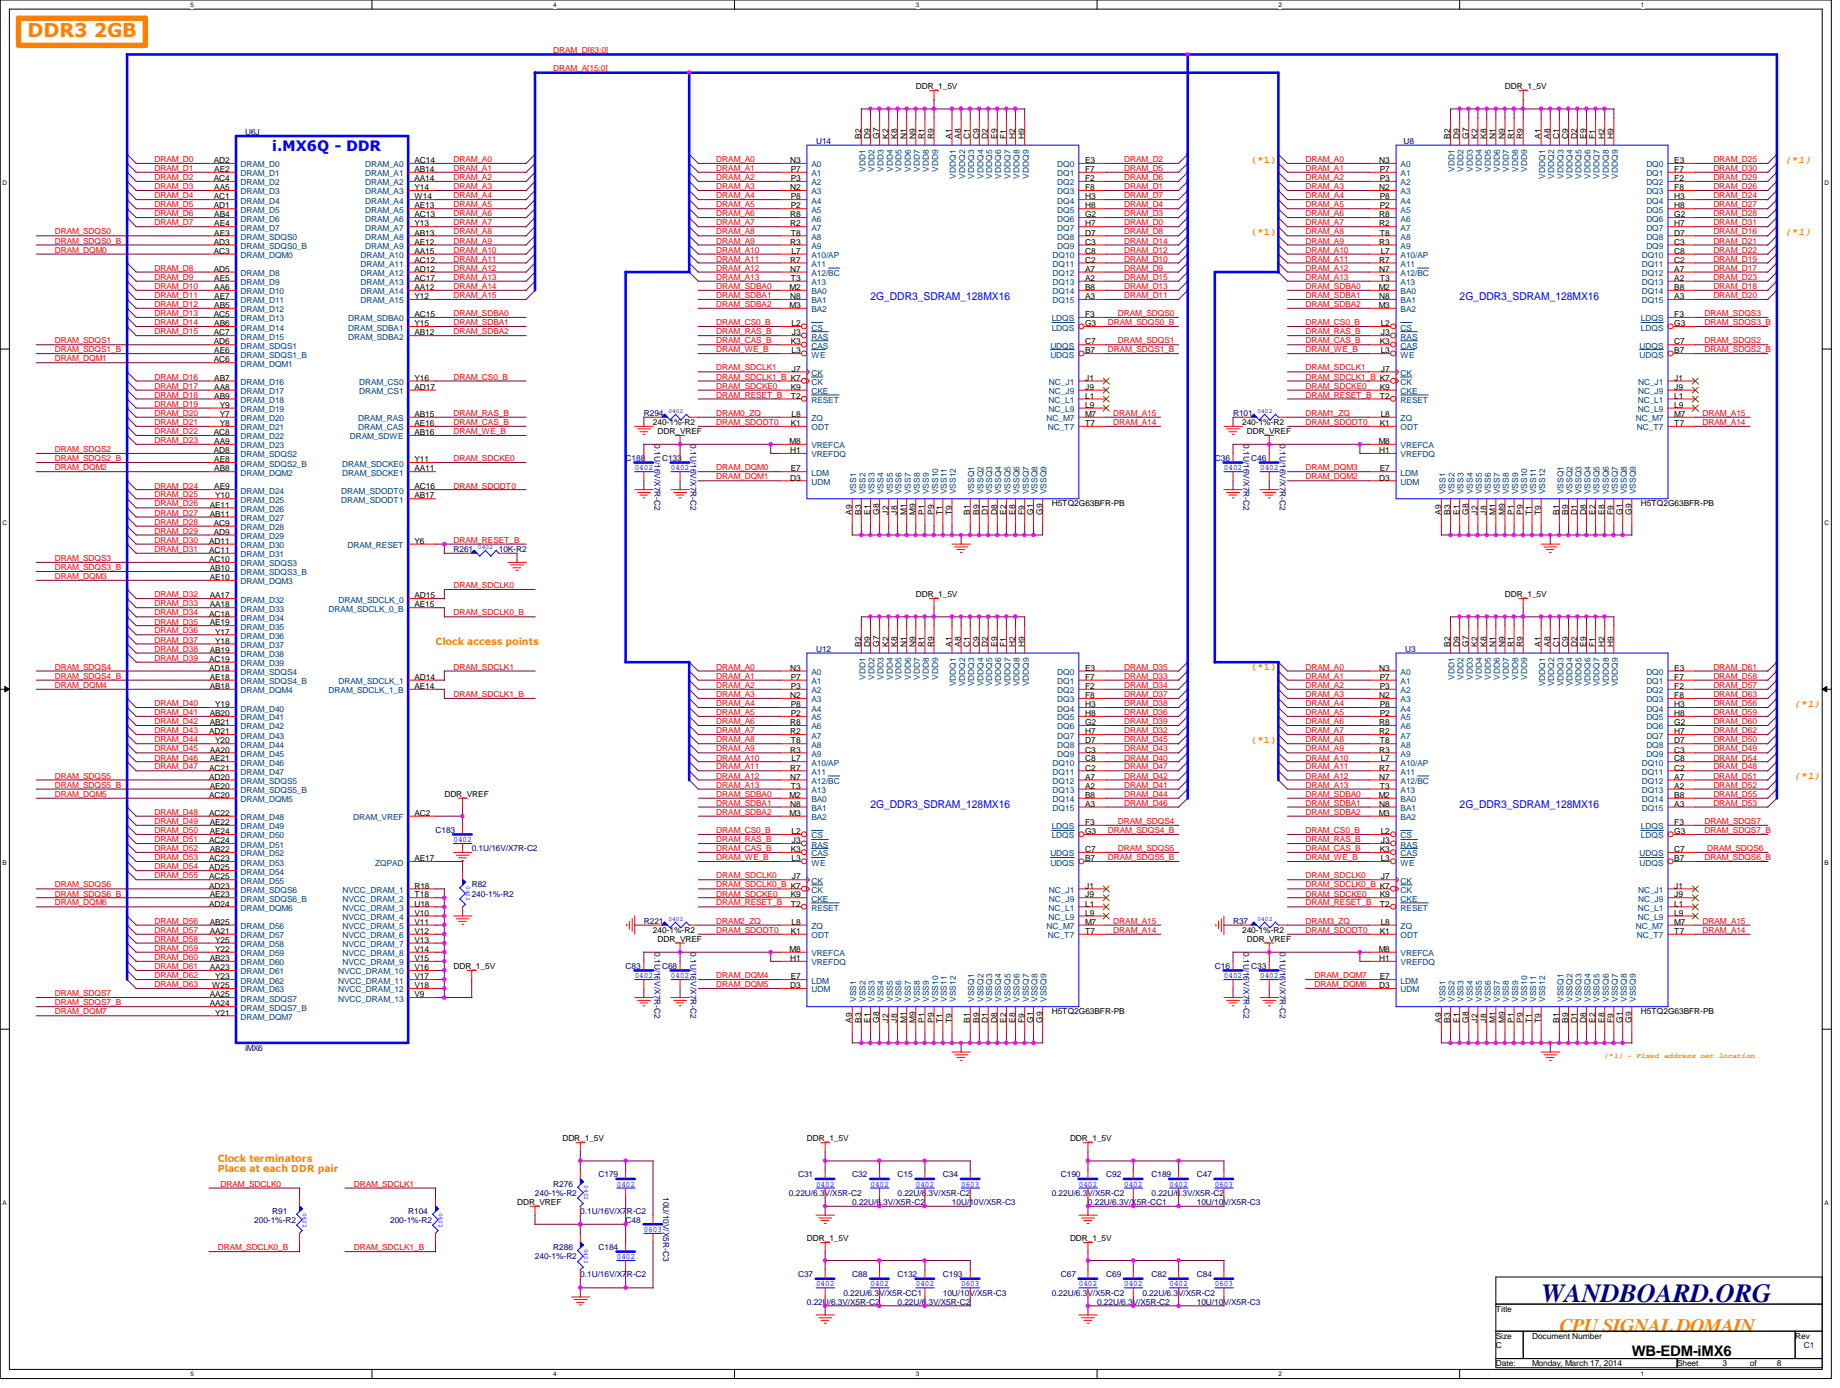
[picture p91: page 3]

DRAM_D[63:0]

DRAM_A[15:0]

(*1) - Fixed address net location

Clock terminators
Place at each DDR pair

## i.MX6Q - EIM

## i.MX6Q

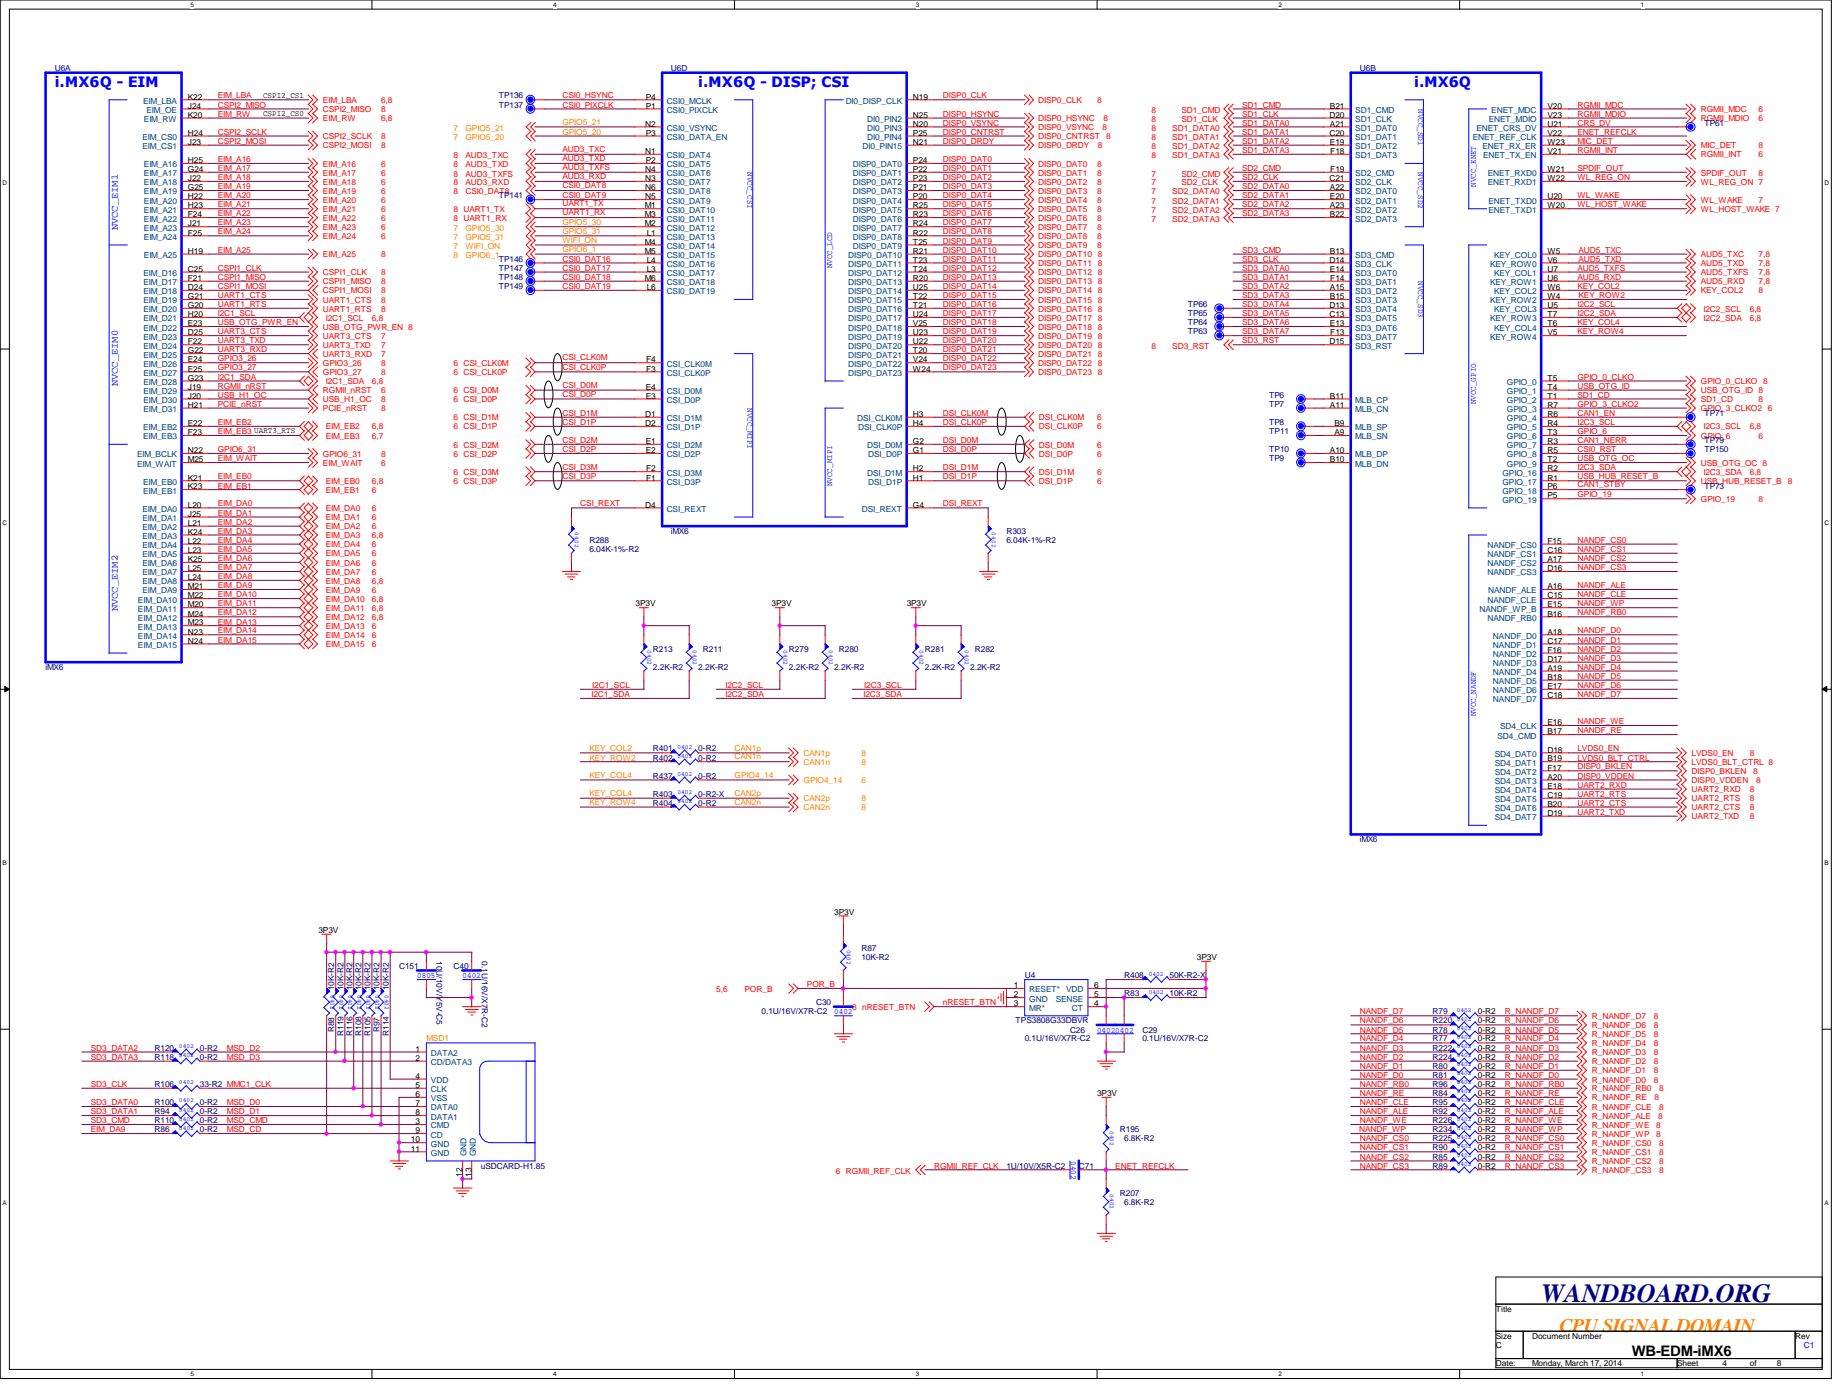
[picture p92: page 4]

R97 10K-R2 U4 TPS3808G33DBVR 123 456 RESET* GND MR* CT SENSE VDD

# DIFF PAIRS

# 0603 4.7U/6.3V/X5R-C3

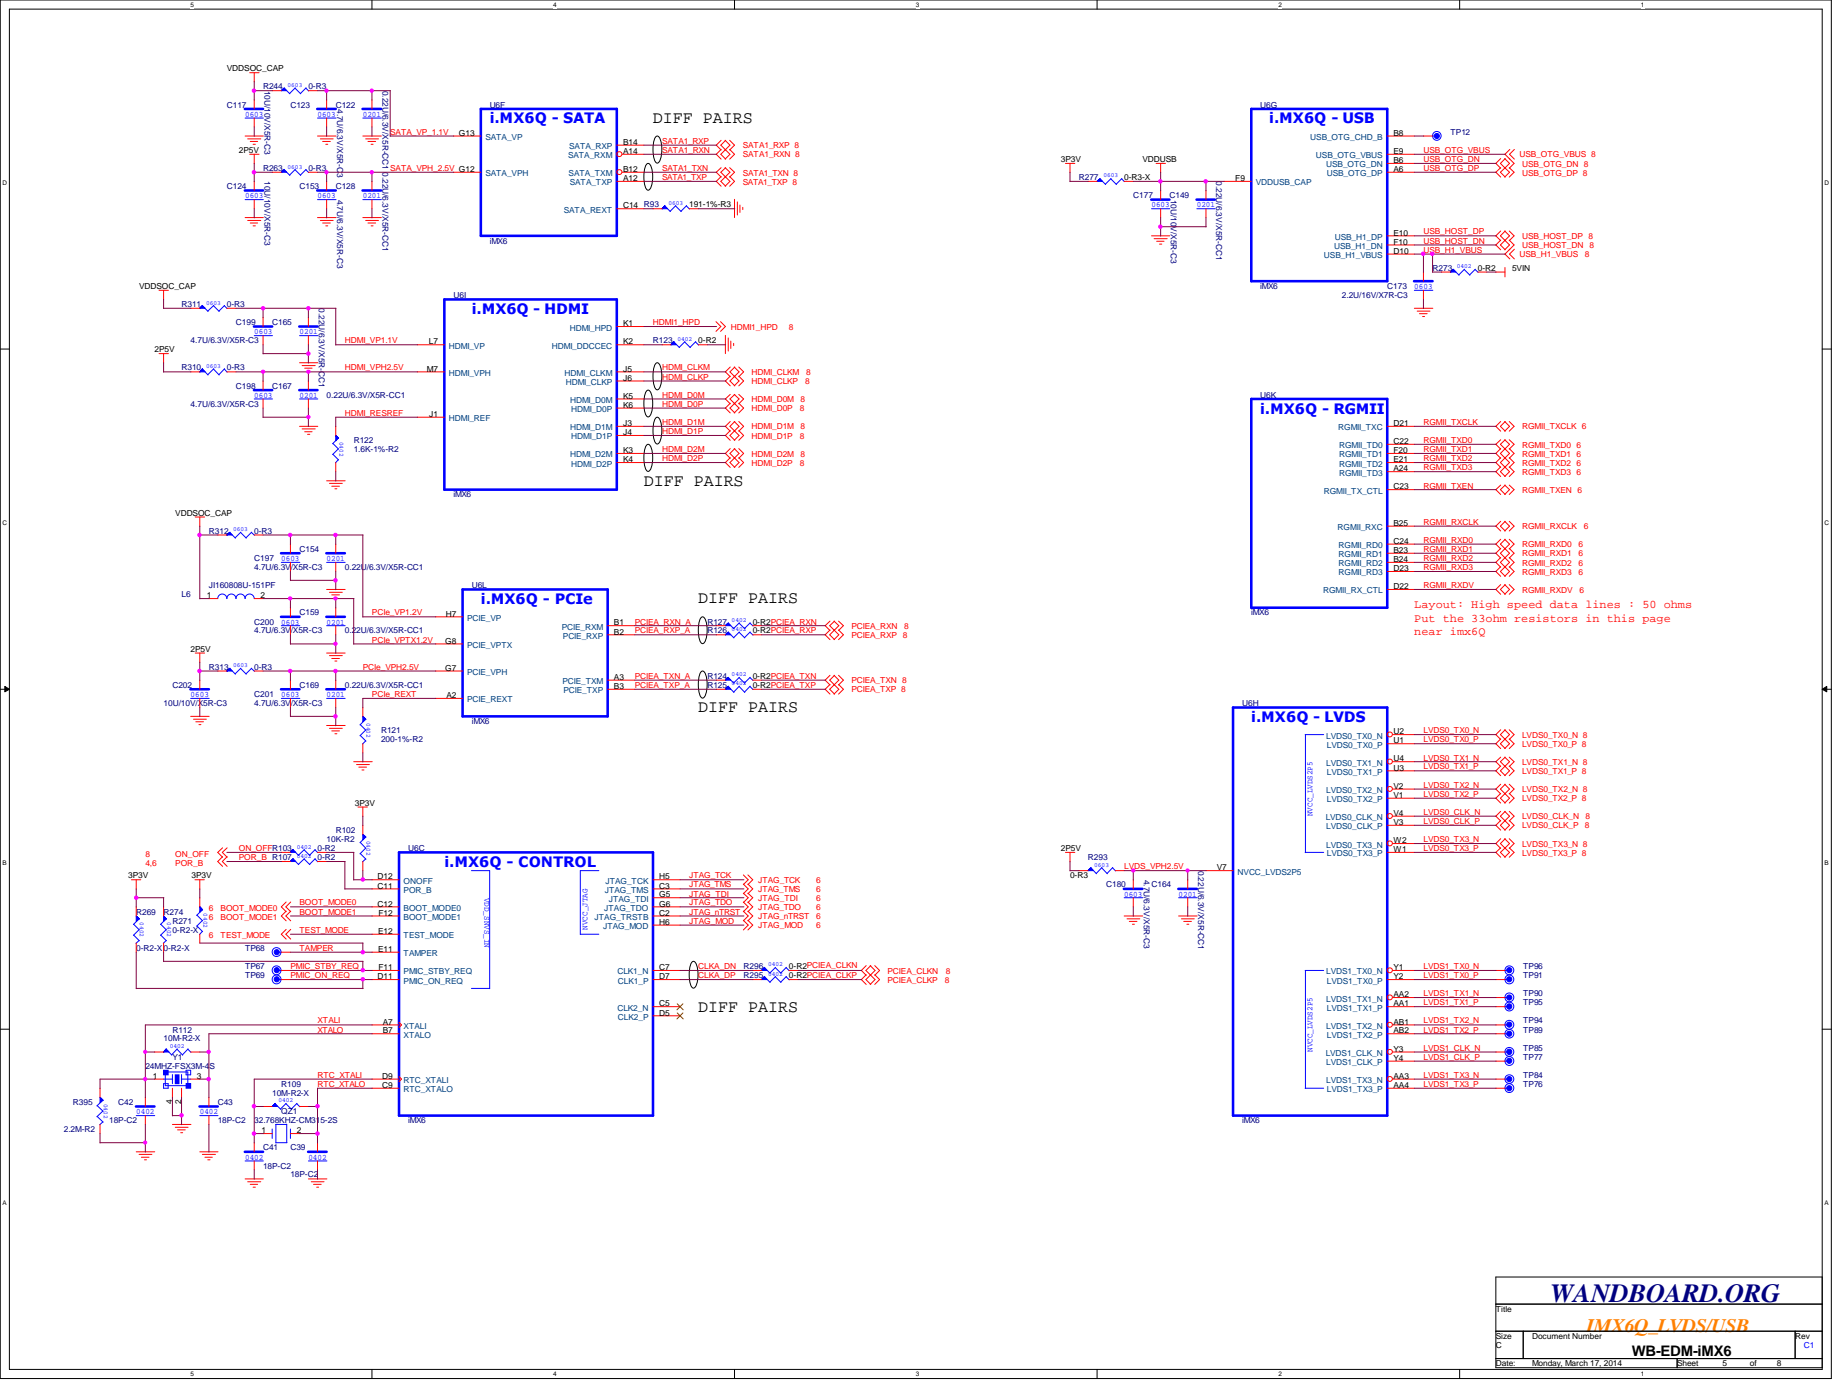
[picture p93: page 5]

Boot Config Select | JTAG

# EEPROM

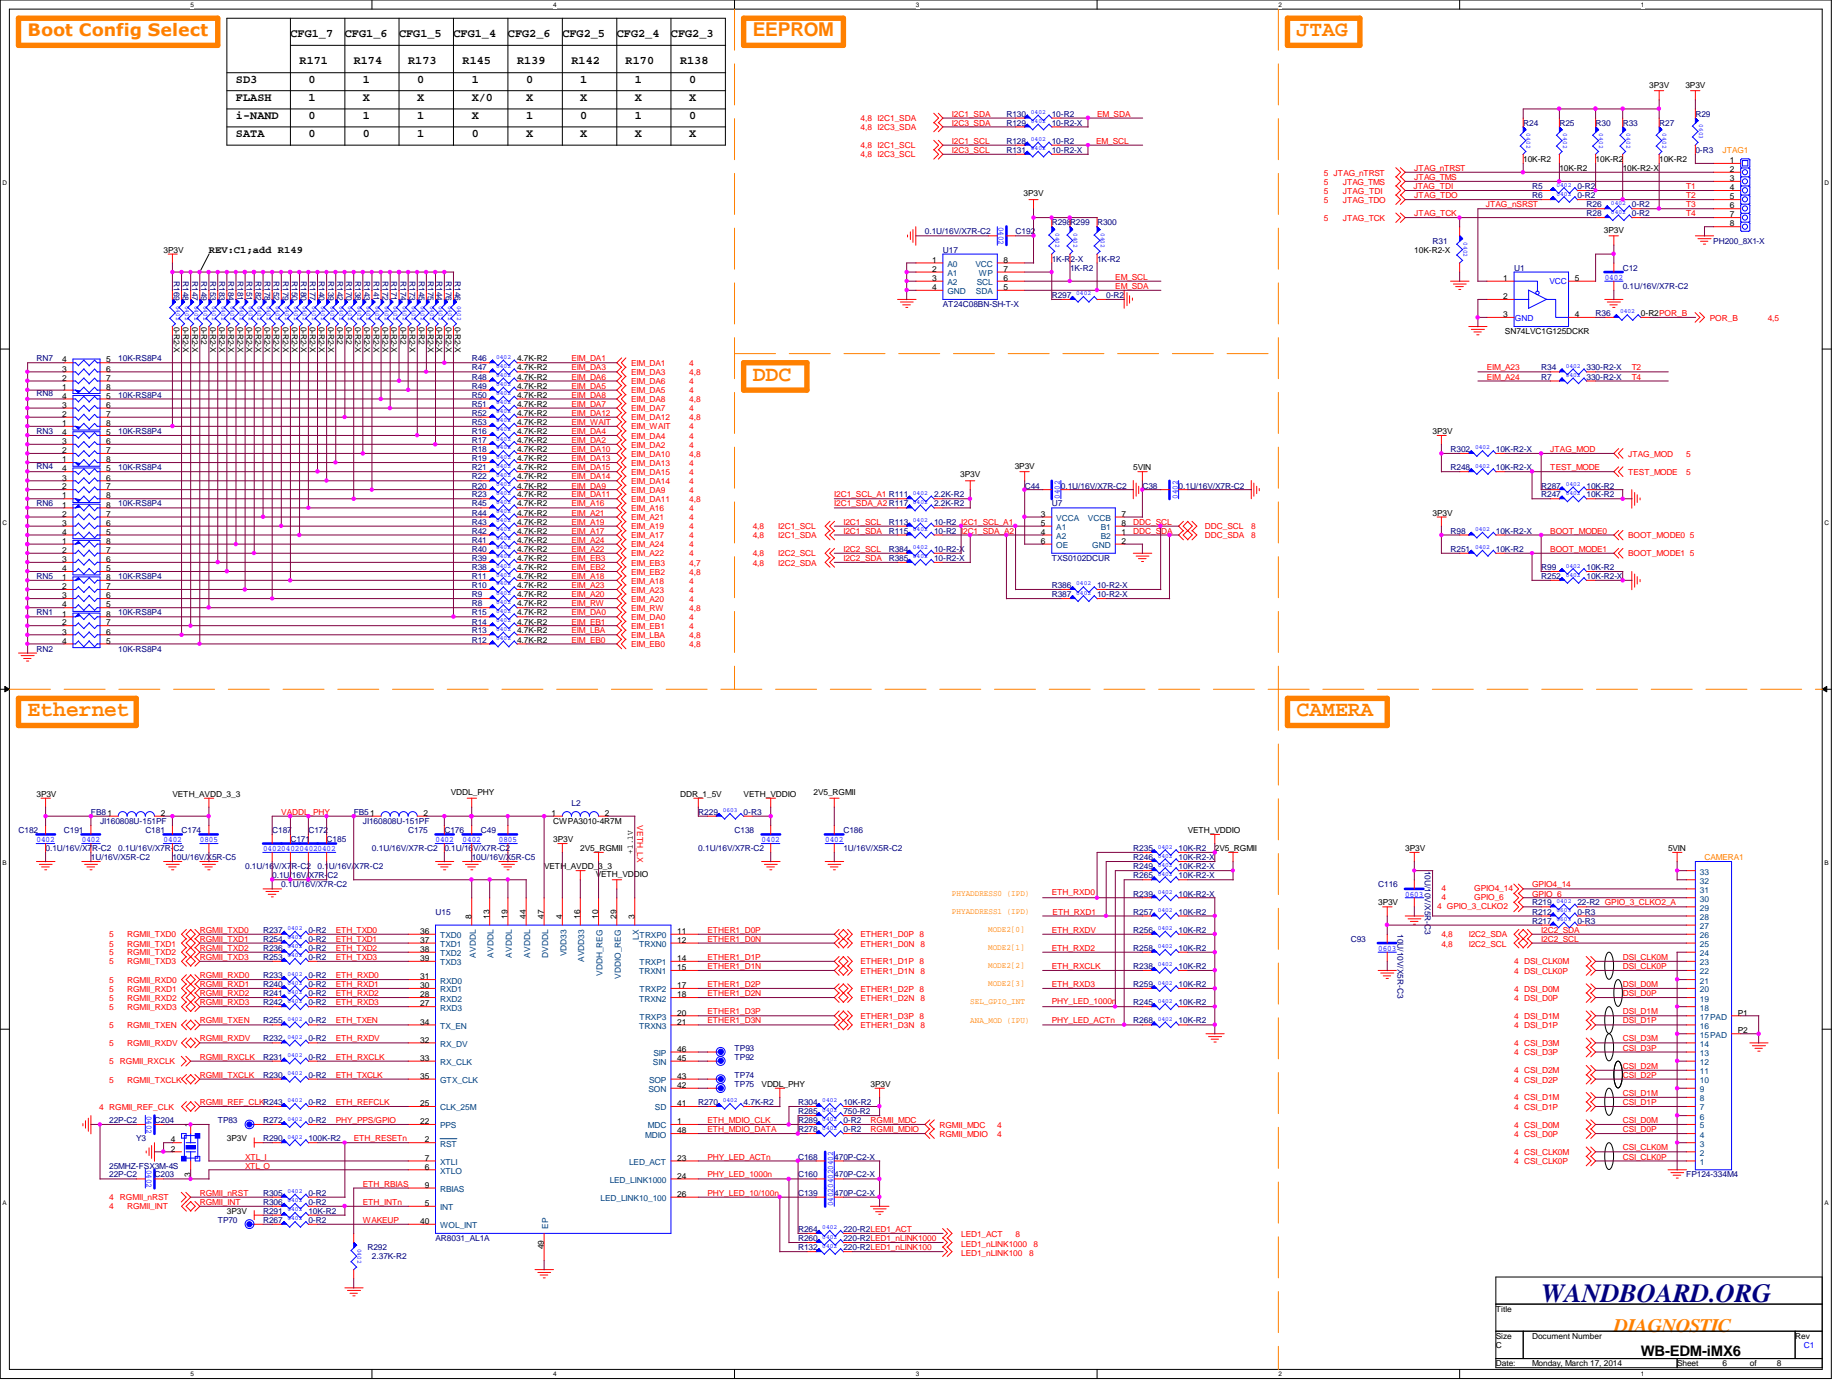
[picture p94: page 6]

SD3 | 0 0 | 1 | 0 | 1 | 0 | 1 | 1
FLASH | 1 | X | X | X/0 | X | X | X | X

2V5_RGMII VETH_AVDD_3_3 DDR_1_5V VETH_VDDIO L2 | 3P3V CAMERA1

# WIFI+BT

## Keep 50ohm

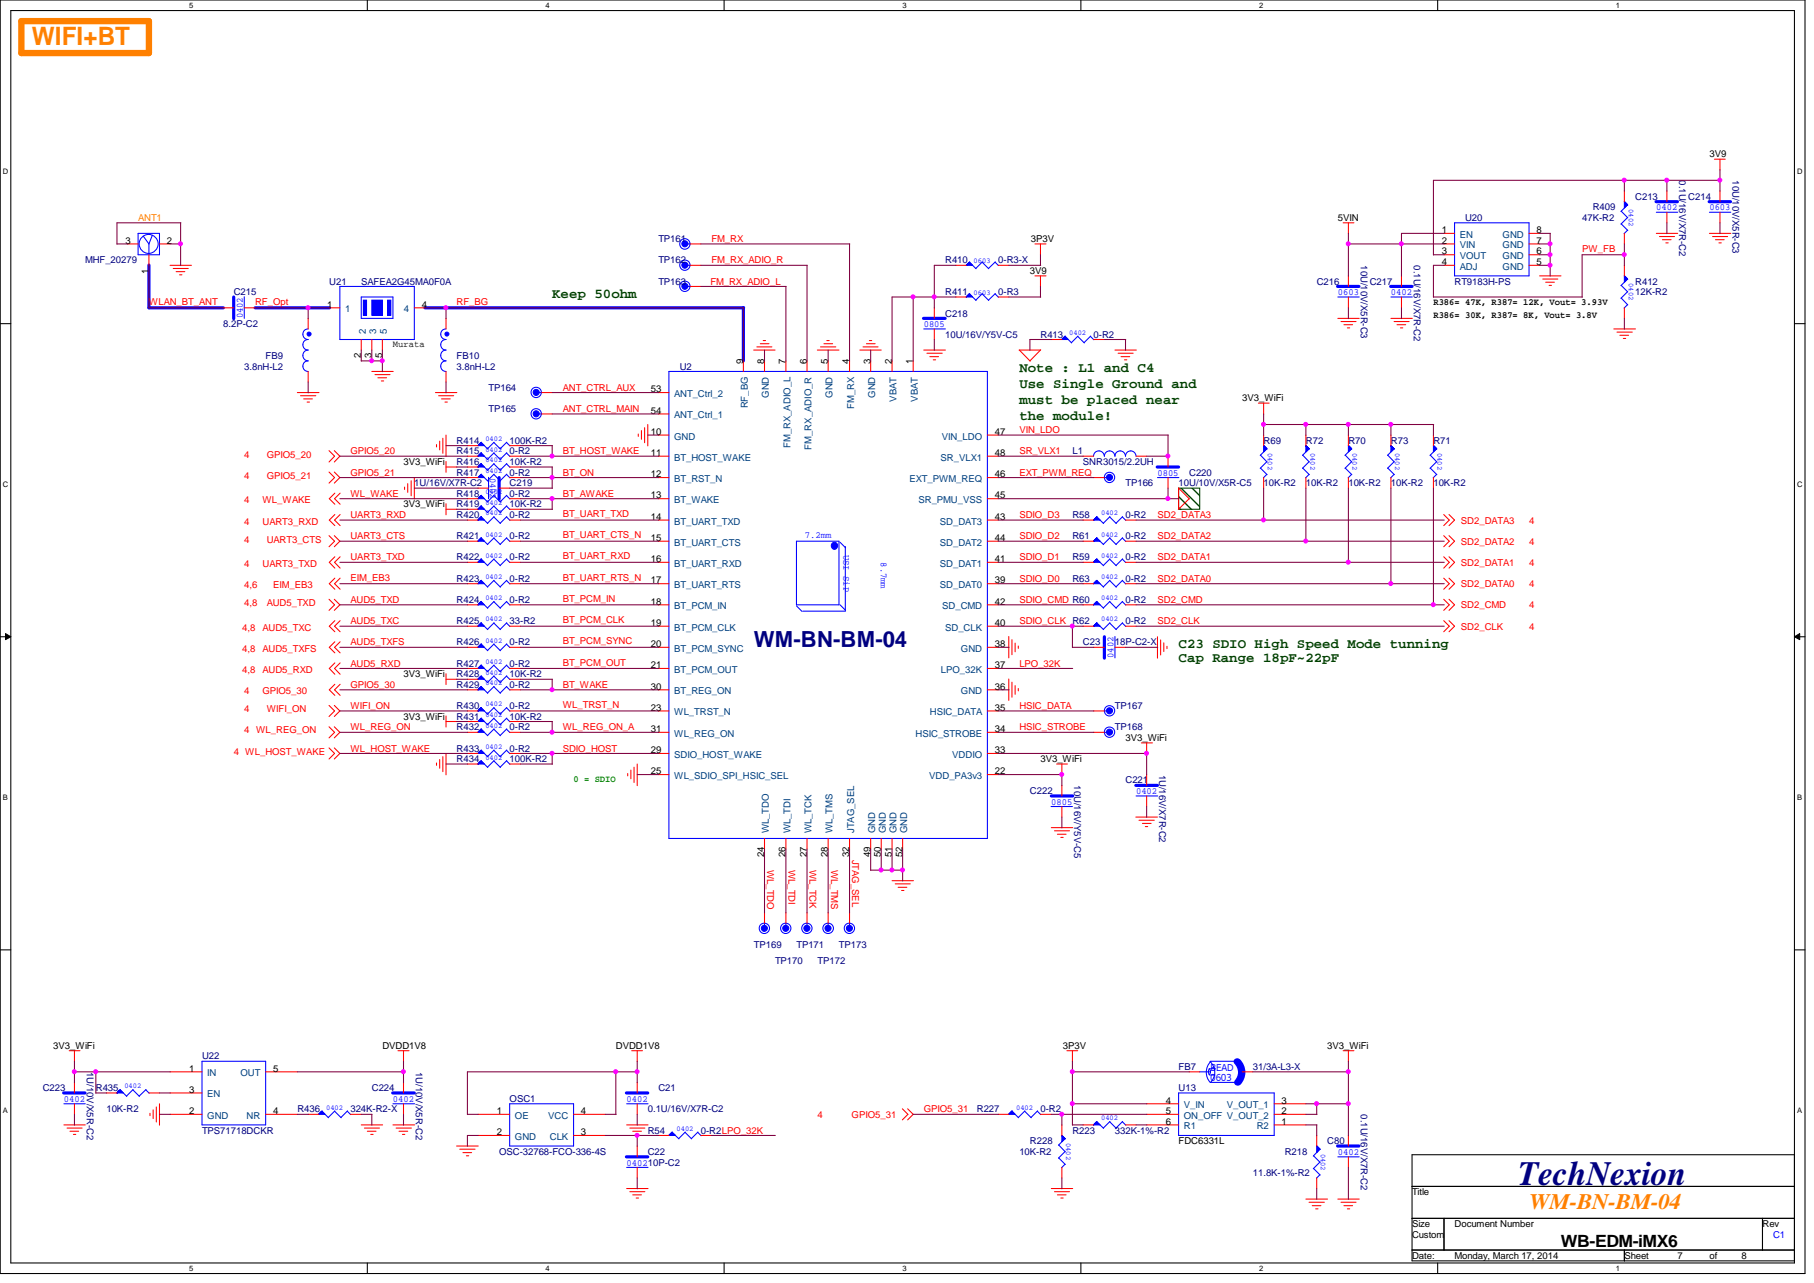
[picture p95: page 7]

SD2_CLK
C23 SDIO High Speed Mode tunning
Cap Range 18pF~22pF

Custom

Monday, March 17, 2014 | 7 8

# Board to Board

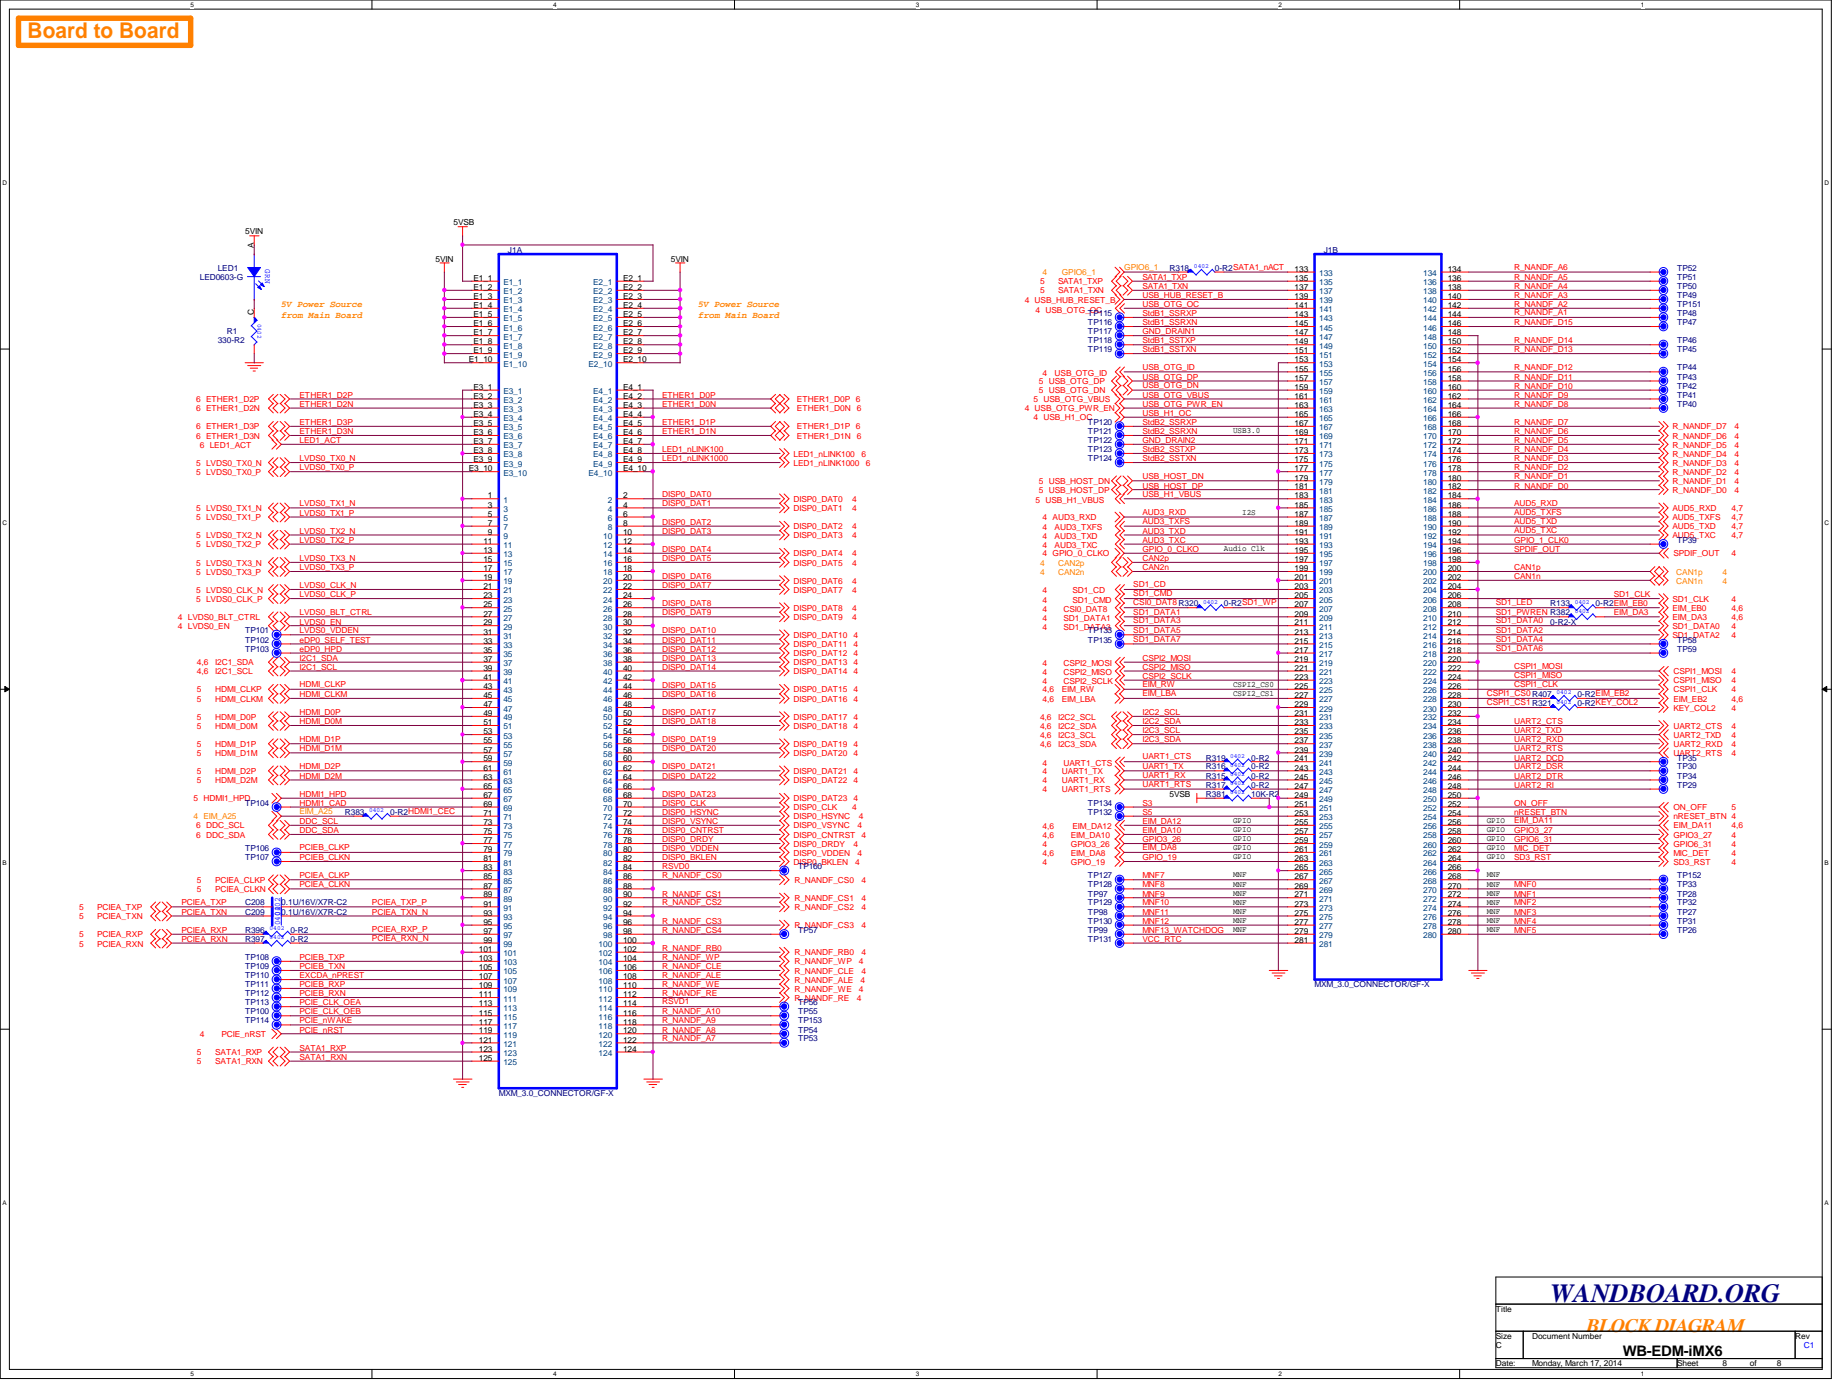
[picture p96: page 8]
