AllAboutCircuits/C-BISCUIT/core/power/crowbar/crowbar.kicad_pcb

## KiCad design core/power/crowbar/crowbar.kicad_pcb (2016-02-29)

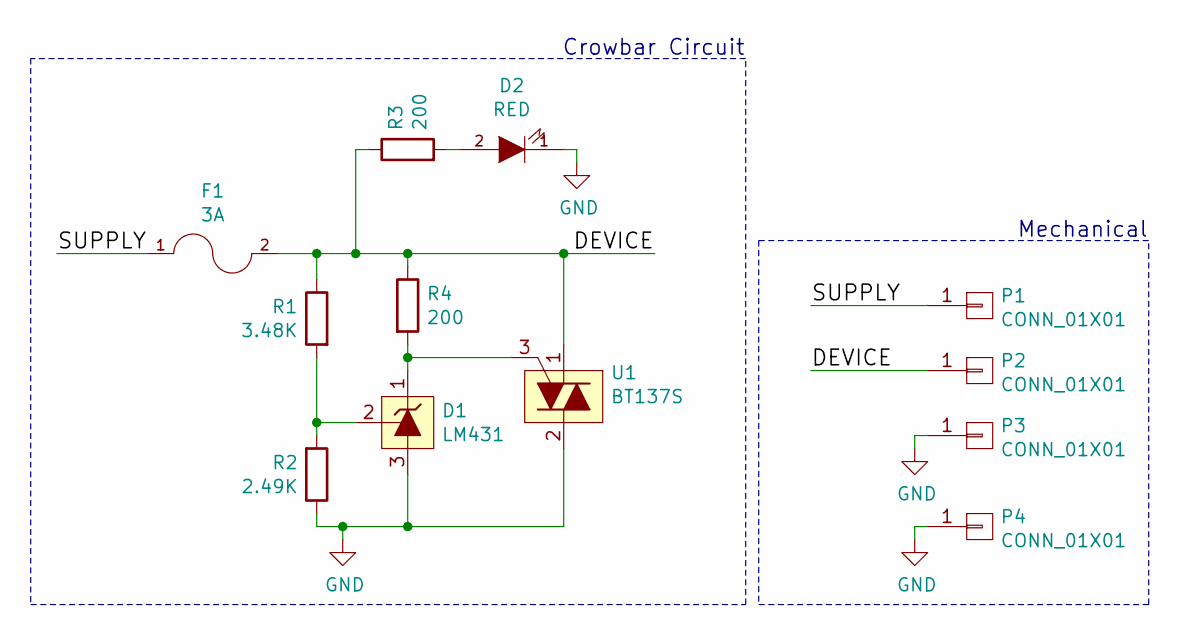
[picture p97: schematic crowbar.sch]

Parts:
D1: LM431; SOT-23_Handsoldering
D2: RED; LED-5MM
F1: 3A; 3549-BLADE-CLIP
P1, P2, P3, P4: CONN_01X01; SolderWirePad_single_SMD_5x10mm
R1: 3.48K; R_0805_HandSoldering
R2: 2.49K; R_0805_HandSoldering
R3, R4: 200; R_0805_HandSoldering
U1: BT137S; TO-252-2Lead

Connections:
/DEVICE: F1.2, P2.1, R1.1, R3.1, R4.1, U1.1 (MT1)
/SUPPLY: F1.1, P1.1
GND: D1.3 (A), D2.1 (K), P3.1, P4.1, R2.1, U1.2 (MT2)
unnamed: D1.1 (K), R4.2, U1.3 (G)
unnamed: D1.2 (Ref), R1.2, R2.2
unnamed: D2.2 (A), R3.2

Notes on the sheet:
Crowbar Circuit
Mechanical

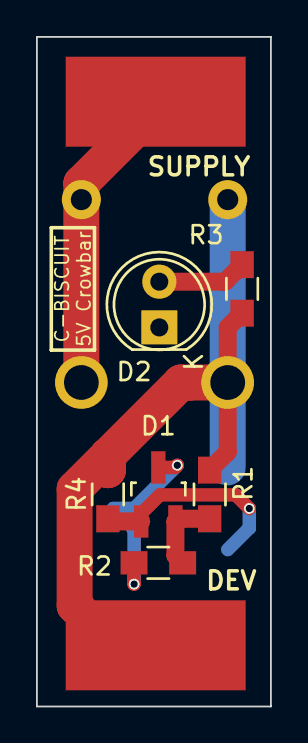
[picture p98: board crowbar.kicad_pcb from above]

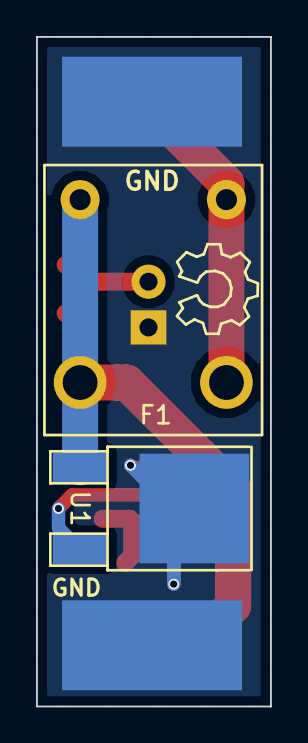
[picture p99: board crowbar.kicad_pcb from below]

Board: 2 copper layers, 13.0 x 37.2 mm, 12 parts (4 on the bottom side), 6 nets.
