AllAboutCircuits/C-BISCUIT/core/power/buck-reg-5v/buck-reg-5v.kicad_pcb

## KiCad design core/power/buck-reg-5v/buck-reg-5v.kicad_pcb (2016-02-24)

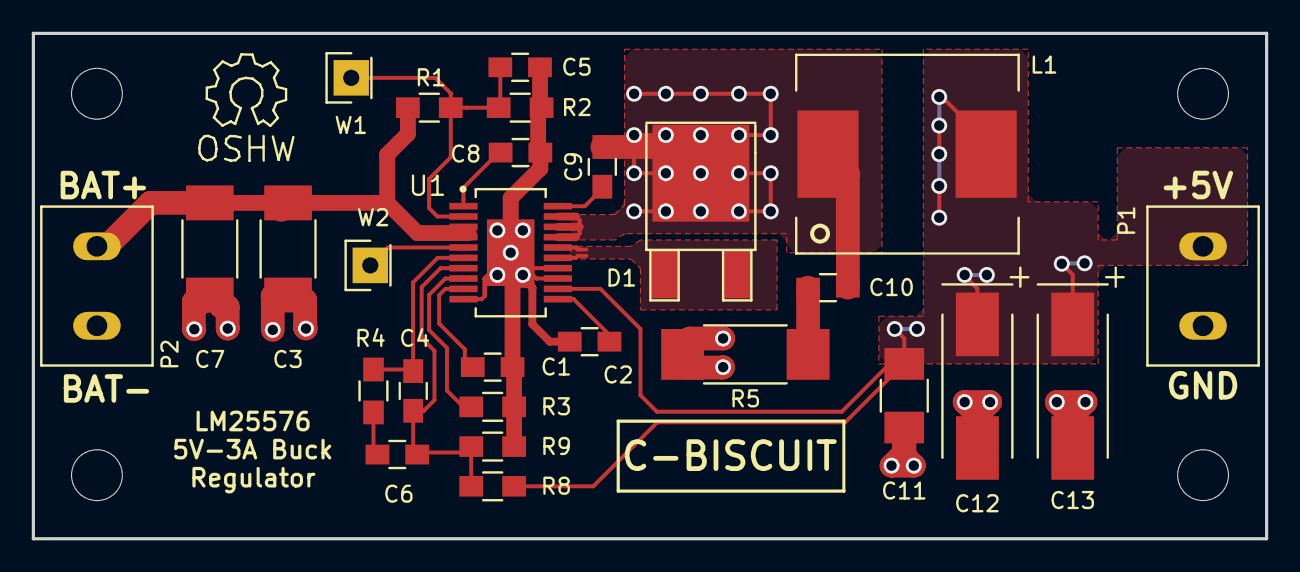
[picture p100: board buck-reg-5v.kicad_pcb from above]

Board: 2 copper layers, 77.6 x 31.8 mm, 27 parts (0 on the bottom side), 16 nets.

Parts:
C1, C10: 330pF; C_0805_HandSoldering
C2, C6: 0.01uF; C_0805_HandSoldering
C3, C7: 2.2uF; C_1812_HandSoldering
C4, C5: DNP; C_0805_HandSoldering
C8: 0.47uF; C_0805_HandSoldering
C9: 0.022uF; C_0805_HandSoldering
C11: 22uF; C_1210_HandSoldering
C12, C13: 150uF; TantalC_SizeD_EIA-7343_HandSoldering
D1: CSHD6-60C; TO-252-2Lead
L1: 33uH; Inductor_EB_DR127
P1, P2: CONN_01X02; Conn_01x02_5.0mm_Phoenix_1935161
R1, R2: DNP; R_0805_HandSoldering
R3: 20.5K; R_0805_HandSoldering
R4: 49.9K; R_0805_HandSoldering
R5: 10; R_2512_HandSoldering
R8: 15.4K; R_0805_HandSoldering
R9: 4.99K; R_0805_HandSoldering
U1: LM25576; SOIC-20-1EP
W1, W2: TP; Socket_Strip_Straight_1x01

Connections:
+5V: C11.1, C12.1, C13.1, L1.2, P1.1, R8.1, U1.12
/BAT_IN: C3.1, C7.1, P2.1, R1.1, U1.3, U1.4
/BST: C9.2, U1.20
/COMP: C4.1, R4.1, U1.6
/FB: C4.2, C6.2, R8.2, R9.1, U1.7
/IS: D1.1, D1.3, U1.15, U1.16
/RAMP: C1.2, U1.9
/RT: R3.1, U1.8
/SD: C5.1, R1.2, R2.1, U1.2, W1.1
/SS: C2.1, U1.11
/SW: C9.1, C10.2, D1.2, L1.1, U1.17, U1.18, U1.19
/SYNC: U1.5, W2.1
/VCC: C8.1, U1.1
GND: C1.1, C2.2, C3.2, C5.2, C7.2, C8.2, C11.2, C12.2, C13.2, P1.2, P2.2, R2.2, R3.2, R5.2, R9.2, U1.10, U1.13, U1.14
unnamed: C6.1, R4.2
unnamed: C10.1, R5.1
