AllAboutCircuits/C-BISCUIT/(commit log)

2016-01-21 Added empty kicad project for the buck coverter board. Probably will be based on TI TPS54394
    [dc-dc-converter.kicad_pcb, dc-dc-converter.sch]
2016-01-21 Added draft of power diagram; shore power
    [dc-dc-converter.kicad_pcb, dc-dc-converter.sch]
2016-01-21 Flow charts and stuff for power stage
2016-01-22 Made several parts, laid down reg crowbar circuit
    [buck-reg-5v.kicad_pcb, buck-reg-5v.sch]
2016-01-25 Laid out reg schematic, made LM25576 symbol, using Molex mega-fit conns
    [buck-reg-5v.sch]
2016-01-25 Finished schematic. Added component values
    [buck-reg-5v.sch]
2016-01-31 Finished part selection, footprints. Added parts to PCB
    [buck-reg-5v.csv, buck-reg-5v.kicad_pcb, buck-reg-5v.sch]
2016-02-01 Finished buck reg PCB but needs review (and M3 holes)
    [buck-reg-5v.kicad_pcb, buck-reg-5v.sch]
2016-02-01 Finished buck reg. Awaiting review
    [buck-reg-5v.kicad_pcb, buck-reg-5v.sch]
2016-02-02 Started article on buck reg
2016-02-02 Broke up power into more articles
2016-02-12 Finished 5V reg (no crowbar) and article to go with it
    [buck-reg-5v.csv, buck-reg-5v.kicad_pcb, buck-reg-5v.sch]
2016-02-12 Added mfg files. Still needs links to parts.
    [bom.csv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]
2016-02-12 links in BOM and zip file for mfg finalized.
    [bom.csv]
2016-02-24 Moved crowbar and bat-mon-swap into .untracked to clean up branch
    [buck-reg-5v.csv, buck-reg-5v.kicad_pcb, buck-reg-5v.sch]
2016-02-24 finished crowbar schematic and chose components
    [crowbar.kicad_pcb, crowbar.sch]
2016-02-26 Finished crowbar and generated mfg files
    [crowbar-B.Cu.gbl, crowbar-B.Mask.gbs, crowbar-B.SilkS.gbo, crowbar-Edge.Cuts.gm1, crowbar-F.Cu.gtl, crowbar-F.Mask.gts, crowbar-F.SilkS.gto, crowbar.drl]
2016-02-29 Finished crowbar article and mfg files
    [crowbar.csv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]
2016-05-23 Modified gitignore to include kicad autosave files
2016-05-23 Moved power assembly stub into article folder
